LvYegor/diploma-bsuir/doc/img/pcb_elegance2.png

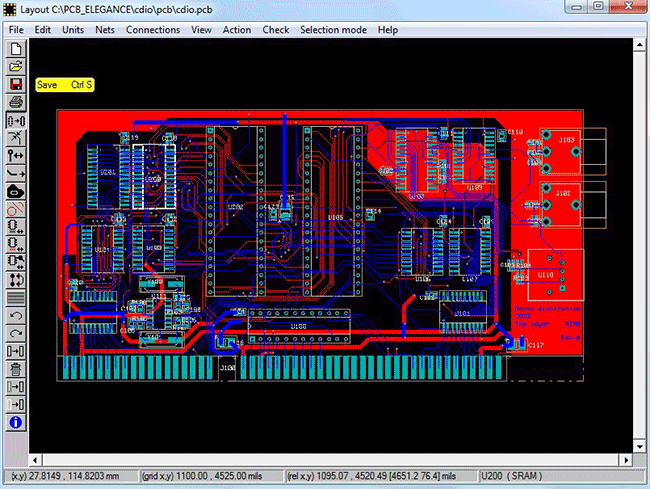
doc/img/pcb_elegance2.png
