LvYegor/diploma-bsuir/doc/img/autoCAD_electrical2.jpg

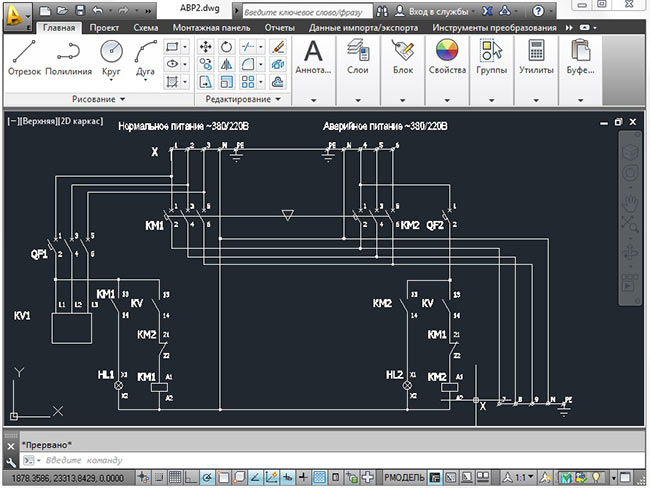
doc/img/autoCAD_electrical2.jpg
