LvYegor/diploma-bsuir/Конференция/Презентация.pdf

## ПРОГРАММНО-АППАРАТНЫЙ КОМПЛЕКС ДЛЯ УПРАВЛЕНИЯ ТЕПЛИЦЕЙ НА ОСНОВЕ БЕСПРОВОДНОЙ ТЕХНОЛОГИИ

Андриевский Егор Сергеевич | Куприянова Диана Вячеславовна

26/04/2024

ДОКЛАДЧИК | РУКОВОДИТЕЛЬ

ДАТА

студент группы 050501 | старший преподаватель кафедры ЭВМ

# ЦЕЛЬ И ЗАДАЧИ

Разработать программно-аппаратный комплекс для управления теплицей на основе беспроводной технологии

## Цель

проектирование контроллера теплицы, представленного в виде платы микроконтроллера и набора датчиков для сбора данных

разработка программного обеспечения для обработки информации и обеспечения взаимодействия между компонентами

реализация удаленного мониторинга и управления теплицей через API

тестирование функционала беспроводного управления и совместимости с подключенными устройствами

## Задачи

# ИСПОЛЬЗУЕМЫЕ ТЕХНОЛОГИИ

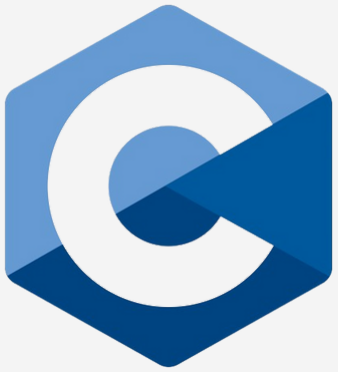
[picture p3: figure]
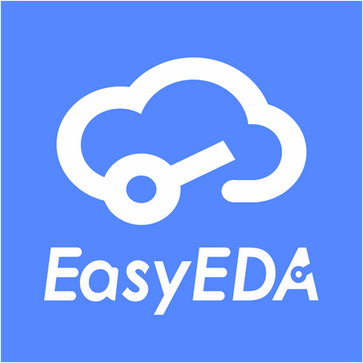
[picture p4: figure]
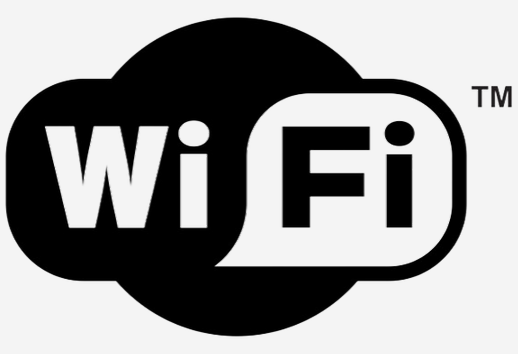
[picture p5: figure]
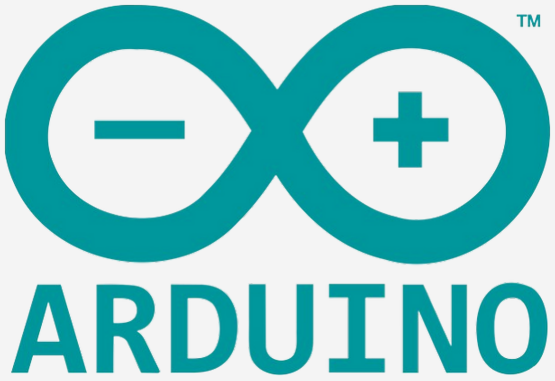
[picture p6: figure]
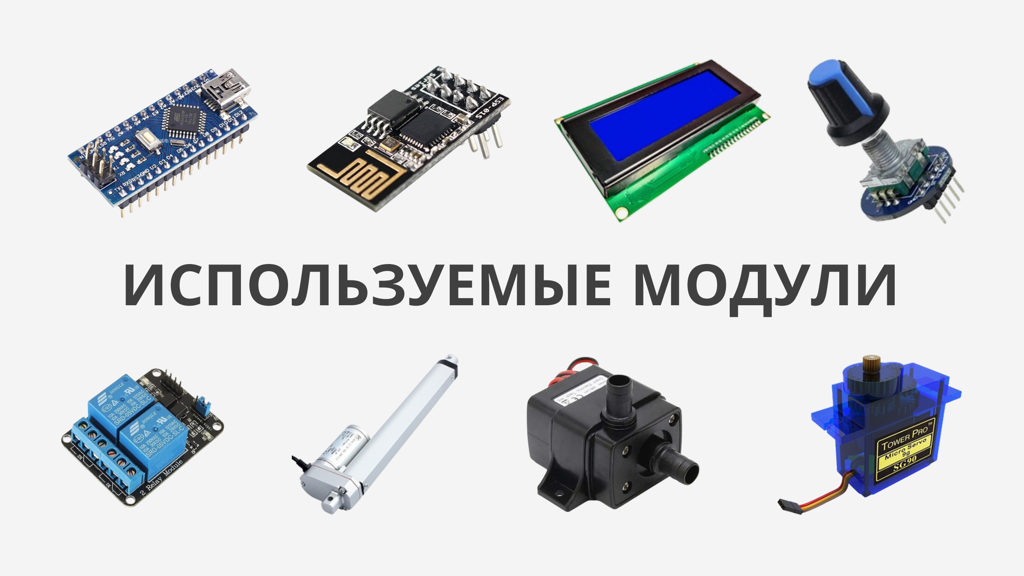
[picture p7: page 4]

# ИСПОЛЬЗУЕМЫЕ МОДУЛИ

# API

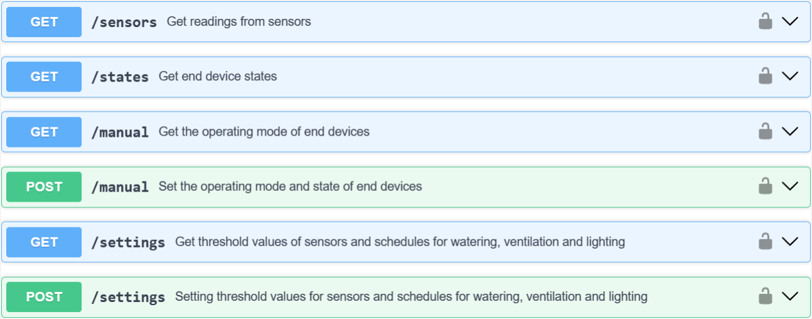
[picture p8: figure]

# ПЕЧАТНАЯ ПЛАТА

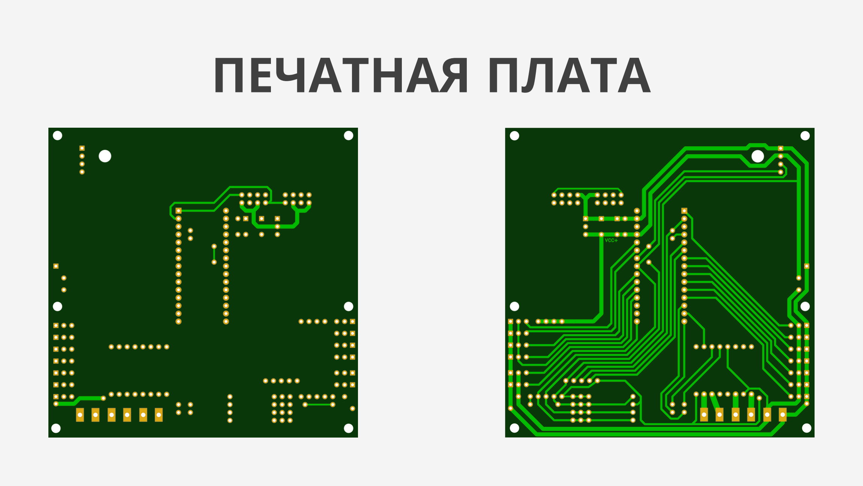
[picture p9: page 6]

# КОРПУС УСТРОЙСТВА

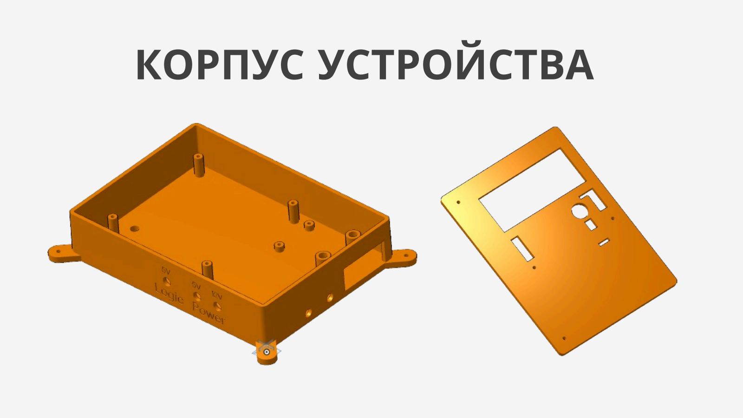
[picture p10: page 7]

# ИСПОЛЬЗУЕМЫЕ ИСТОЧНИКИ

[1]Документация Arduino Nano [Электронный ресурс]. – Электронные данные. – Режим доступа: https://store.arduino.cc/products/arduino-nano – Дата доступа: 03.04.2024

[2]EasyEDA | [Электронный | ресурс]. | – | Электронные | данные. | – | Режим | доступа:
https://easyeda.com/ru – Дата доступа: 03.04.2024

[3]UART – Последовательный интерфейс передачи данных [Электронный ресурс]. – Электронные данные. – Режим доступа: https://voltiq.ru/wiki/uart-interface/ – Дата доступа: 17.04.2024

[4]Интерфейс I2C: принципы функционирования [Электронный ресурс]. – Электронные данные. – Режим доступа: https://dzen.ru/a/Y8-Xp4mc1StLbKbz – Дата доступа: 17.04.2024

[5]ESP-01 WiFi Module [Электронный ресурс]. – Электронные данные. – Режим доступа: https://www.microchip.ua/wireless/esp01.pdf – Дата доступа: 17.04.2024
