LvYegor/diploma-bsuir/doc/Титульный_Лист_ДП.docx

Министерство образования Республики Беларусь

Учреждение образования

БЕЛОРУССКИЙ ГОСУДАРСТВЕННЫЙ УНИВЕРСИТЕТ

ИНФОРМАТИКИ И РАДИОЭЛЕКТРОНИКИ

Факультет компьютерных систем и сетей

Кафедра электронных вычислительных машин

К ЗАЩИТЕ ДОПУСТИТЬ

Зав. каф. ЭВМ

___________ Б.В. Никульшин

ПОЯСНИТЕЛЬНАЯ ЗАПИСКА

к дипломному проекту

на тему

ПРОГРАММНО-АППАРАТНЫЙ КОМПЛЕКС ДЛЯ УПРАВЛЕНИЯ ТЕПЛИЦЕЙ НА ОСНОВЕ БЕСПРОВОДНОЙ ТЕХНОЛОГИИ

БГУИР ДП 1–40 02 01 01 005 ПЗ

Студент Е.С. Андриевский

Руководитель Д.В. Куприянова

Консультанты:

от кафедры ЭВМ Д.В. Куприянова

по экономической части В.Г. Горовой

Нормоконтролер А.И. Стракович

Рецензент

МИНСК 2024
