LvYegor/diploma-bsuir/ПДП/Титульный_Лист_ПДП.docx

Министерство образования Республики Беларусь

Учреждение образования

БЕЛОРУССКИЙ ГОСУДАРСТВЕННЫЙ УНИВЕРСИТЕТ

ИНФОРМАТИКИ И РАДИОЭЛЕКТРОНИКИ

Факультет компьютерных систем и сетей

Кафедра электронных вычислительных машин

Отчет по преддипломной практике

Студент Е.С. Андриевский

Руководитель Д.В. Куприянова

Консультант от кафедры ЭВМ Д.В. Куприянова

Нормоконтролер А.И. Стракович

МИНСК 2024
