LvYegor/diploma-bsuir/doc/pdf/Ведомость_А4.pdf

Изм. Лист | | № докум. | Подп. | Дата
Разраб. | Андриевский | | | Программно-аппаратный комплекс для управления теплицей. Ведомость документов | Лит. | Лист | Листов
Пров. | Куприянова | | | | | У | | 1 | 2
Т. контр. | Куприянова | | | | ЭВМ, гр. 050501
Н. контр. | Стракович
Утв. | Никульшин

## БГУИР ДП 1–400201 01 005 Д1

Обозначение | Наименование | Примечание
| Графические документы
ГУИР.400201.005 ПД.1 ГУИР.400201.005 ПД.1 | Программное обеспечение Программное обеспечение
| контроллера теплицы для Arduino. контроллера теплицы для Arduino.
| Схема программы Схема программы | А2 А2
ГУИР.400201.005 ПД.2 ГУИР.400201.005 ПД.2 | Программное обеспечение Программное обеспечение
| контроллера теплицы для ESP-01. контроллера теплицы для ESP-01.
| Схема программы Схема программы | А2 А2
ГУИР.400201.005 ПЛ.1 | Вводный плакат. Плакат | А1
ГУИР.400201.005 ПЛ.2 | Заключительный плакат. Плакат | А1
ГУИР.400201.005 Э1 ГУИР.400201.005 Э1 | Программно-аппаратный комплекс для Программно-аппаратный комплекс для
| управления теплицей. управления теплицей.
| Схема электрическая структурная Схема электрическая структурная | А1 А1
ГУИР.400201.005 С1 ГУИР.400201.005 С1 | Программно-аппаратный комплекс для Программно-аппаратный комплекс для
| управления теплицей. управления теплицей.
| Схема структурная Схема структурная | А1 А1
ГУИР.400201.005 Э3 ГУИР.400201.005 Э3 | Программно-аппаратный комплекс для Программно-аппаратный комплекс для
| управления теплицей. управления теплицей.
| Схема электрическая принципиальная Схема электрическая принципиальная | А1 А1
ГУИР.400201.005 МЭ ГУИР.400201.005 МЭ | Программно-аппаратный комплекс для Программно-аппаратный комплекс для
| управления теплицей. управления теплицей.
| Чертеж электромонтажный Чертеж электромонтажный | А4 А4
| Текстовые документы
БГУИР ДП БГУИР ДП 1–400201 01 005 400201 01 005 ПЗ | Пояснительная записка Пояснительная записка | 157 с.
ГУИР.400201.005 Д2 ГУИР.400201.005 Д2 | Программно-аппаратный комплекс для Программно-аппаратный комплекс для
| управления теплицей. управления теплицей.
| Спецификация Спецификация | 1 л., в ПЗ

Изм. Лист | № докум. | Подп. | Дата

## БГУИР ДП 1–400201 01 005 Д1

Лист
2
Обозначение | Наименование | Примечание
ГУИР.400201.005 ПЭ3 | Программно-аппаратный комплекс для
| управления теплицей.
| Перечень элементов | 2 л., в ПЗ
| Отзыв руководителя
| Отчет проверки на заимствования | 2 л.
| Рецензия
