LvYegor/diploma-bsuir/doc/pdf/Перечень_элементов_А4.pdf

Изм. Лист | | № докум. | Подп. | Дата
Разраб. | Андриевский | | | Программно-аппаратный комплекс для управления теплицей. Перечень элементов | Лит. | Лист | Листов
Пров. | Куприянова | | | | | У | | 1 | 2
Т. контр. | Куприянова | | | | ЭВМ, гр. 050501
Н. контр. | Стракович
Утв. | Никульшин

## ГУИР.400201.005 ПЭ3

Поз. обозна-чение | Наименование | | Примечание
| Микросхемы
B1 B1 | GY-30 (BH1750FVI), датчик интенсивности GY-30 (BH1750FVI), датчик интенсивности
| освещенности освещенности | 1 1
B2 B2 | DHT22, модуль датчика температуры и DHT22, модуль датчика температуры и
| влажности влажности | 1 1
B3 | Water Sensor, датчик уровня воды | 1
B4 B4 | BME280, датчик атмосферного давления, BME280, датчик атмосферного давления,
| влажности и температуры влажности и температуры | 1 1
B5, B6 | YL-38, датчик влажности почвы | 2
B7 | YL-69, щуп датчика влажности почвы | 1
B8 | MH-RD, щуп датчика дождя | 1
DA1 DA1 | AMS1117 mini 3,3В, модуль стабилизатора AMS1117 mini 3,3В, модуль стабилизатора
| напряжения напряжения | 1 1
DD1 | ESP-01 (ESP8266), модуль WiFi | 1
DD2 | TB6612FNG Ultra L298N, драйвер моторов
| двухканальный | 1
DD3 DD3 | Nano V3.0 ATmega328P CH340G 16 МГц, Nano V3.0 ATmega328P CH340G 16 МГц,
| плата микроконтроллера плата микроконтроллера | 1 1
DD4 DD4 | DS3231 (AT24C32), 3,3В / 5В, модуль RTC DS3231 (AT24C32), 3,3В / 5В, модуль RTC
| часов реального времени часов реального времени | 1 1
DD5 DD5 | HW-061, модуль последовательного HW-061, модуль последовательного
| интерфейса I2C для дисплея LCD2004 интерфейса I2C для дисплея LCD2004 | 1 1
DD6 DD6 | EC11, модуль энкодера с кнопкой и ручкой EC11, модуль энкодера с кнопкой и ручкой
| 360°, 20 импульсов за цикл 360°, 20 импульсов за цикл | 1 1
EL1 | SMD2835, светодиодная лента, 12В, 9,6Вт | 1
HG1 | LCD2004 IIC/I2C, ЖК-дисплей 20х4 символов | 1
M1 M1 | DC30E, насос центробежный погружной с DC30E, насос центробежный погружной с
| мокрым ротором, 240 л/ч, 12В, 4,2Вт мокрым ротором, 240 л/ч, 12В, 4,2Вт | 1 1

Зона
Кол.

Изм. Лист | № докум. | Подп. | Дата

## ГУИР.400201.005 ПЭ3

Поз. обозна-чение | Наименование | | Примечание
M2 M2 | 750N, линейный привод (актуатор), 12 В, 750N, линейный привод (актуатор), 12 В,
| длина хода 350 мм., 10 мм/с, до 75 кг длина хода 350 мм., 10 мм/с, до 75 кг | 1 1
M3, M4 | SG90, cервопривод, 1,8 кг.см, 180° | 2

Зона
Кол.

Лист
2
| Устройства коммутации
KM1 | Модуль реле, 2 канала, 5В | 1
SW1 SW1 | PBS-10B-2, кнопка без фиксации OFF-(ON), 1А, PBS-10B-2, кнопка без фиксации OFF-(ON), 1А,
| 250В 250В | 1 1
| Блоки питания
XP1 | Блок питания, 12В, 5А | 1
XP2, XP3 Блок питания, Блок питания, 5В, 2А | | 2
