LvYegor/diploma-bsuir/doc/pdf/Презентация.pdf

# Программно-аппаратный комплекс для управления теплицей на основе беспроводной технологии

Автор:
Андриевский Егор Сергеевич

Руководитель:
Куприянова Диана Вячеславовна

# Цель и задачи

Цель:
Разработать программно-аппаратный комплекс для управления теплицей на основе беспроводной технологии Wi-Fi.
Задачи:
– проектирование контроллера теплицы, представленного в виде платы микроконтроллера и набора датчиков для сбора данных;
– разработка программного обеспечения для обработки информации и обеспечения взаимодействия между компонентами;
– реализация удаленного мониторинга и управления теплицей через API;
– тестирование функционала беспроводного управления и совместимости с подключенными устройствами.

# Аналоги

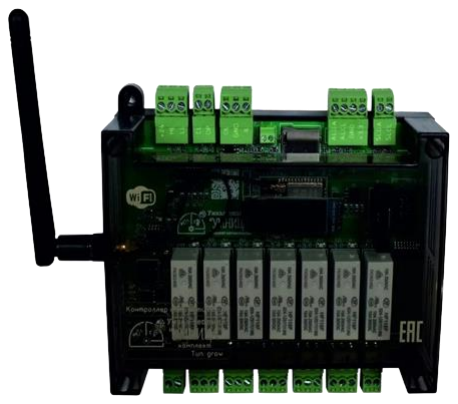
[picture p70: figure]
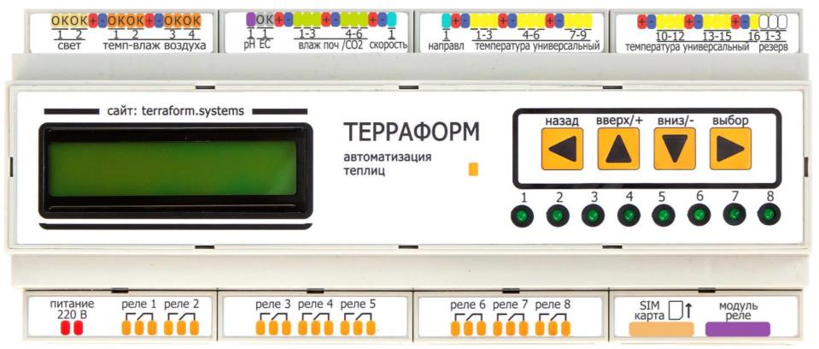
[picture p71: figure]

TECH-UC1002 | УМНИЦА GROW | ТЕРРАФОРМ

# Используемые технологии

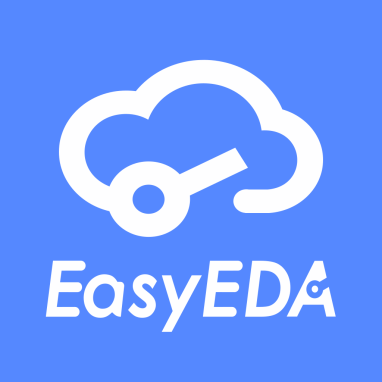
[picture p72: figure]
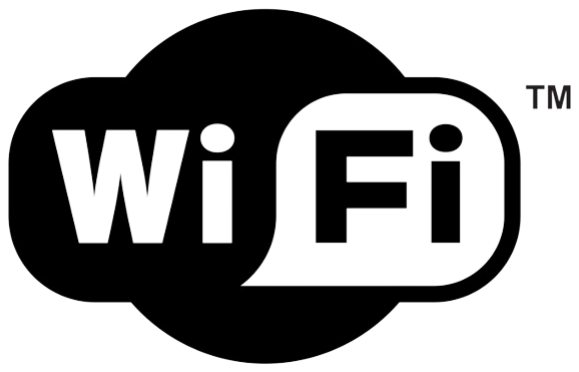
[picture p73: figure]
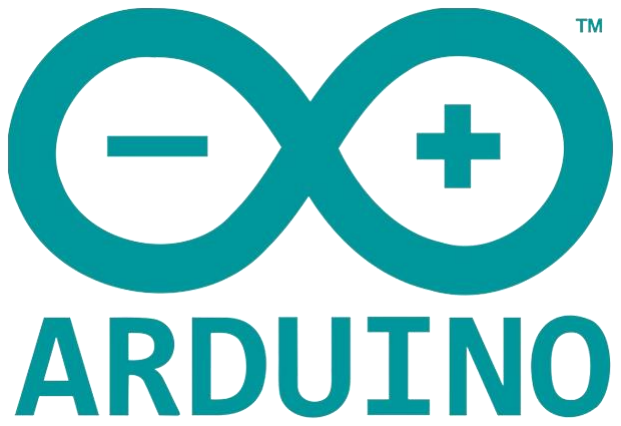
[picture p74: figure]
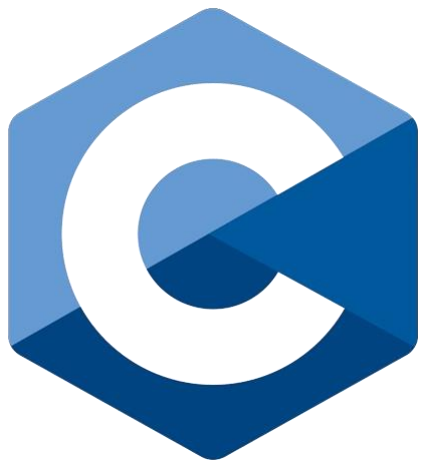
[picture p75: figure]

# Используемые модули

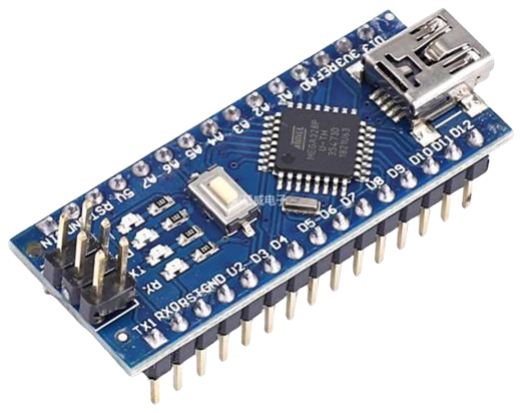
[picture p76: figure]
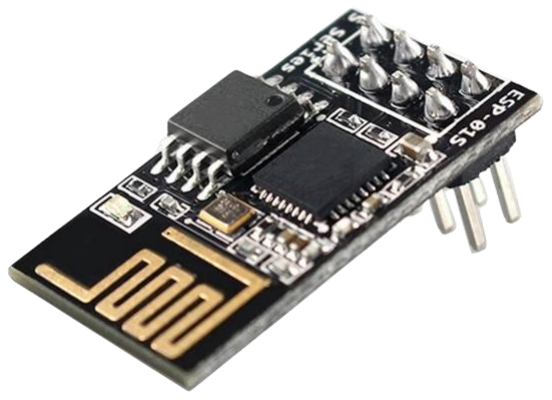
[picture p77: figure]
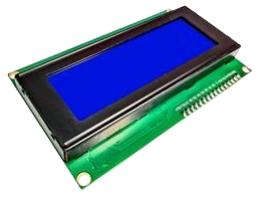
[picture p78: figure]
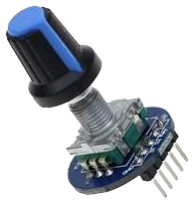
[picture p79: figure]
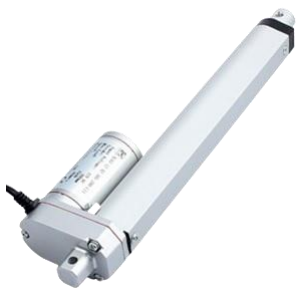
[picture p80: figure]
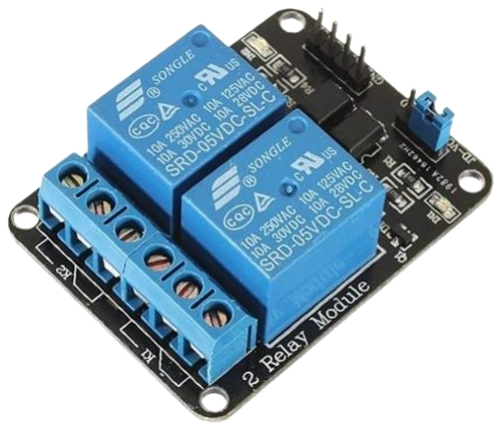
[picture p81: figure]
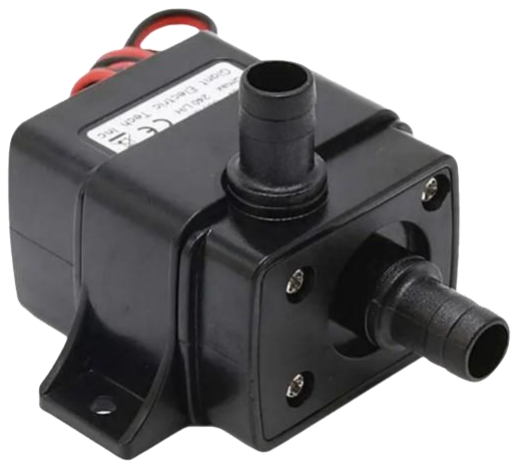
[picture p82: figure]
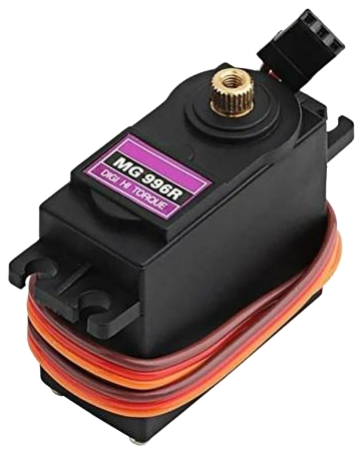
[picture p83: figure]

# Печатная плата

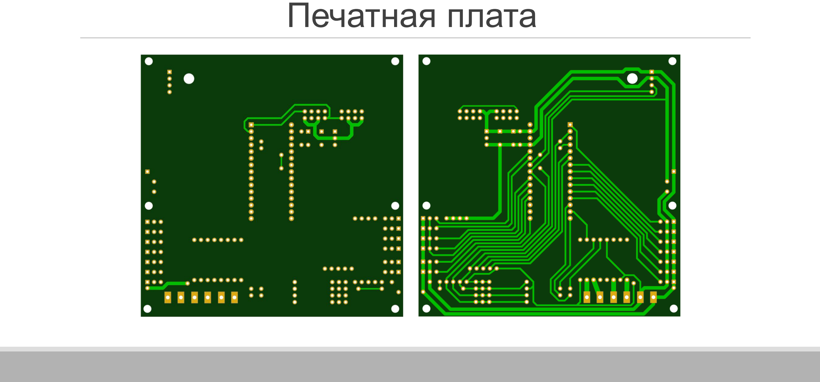
[picture p84: page 6]

# Разработанный контроллер теплицы

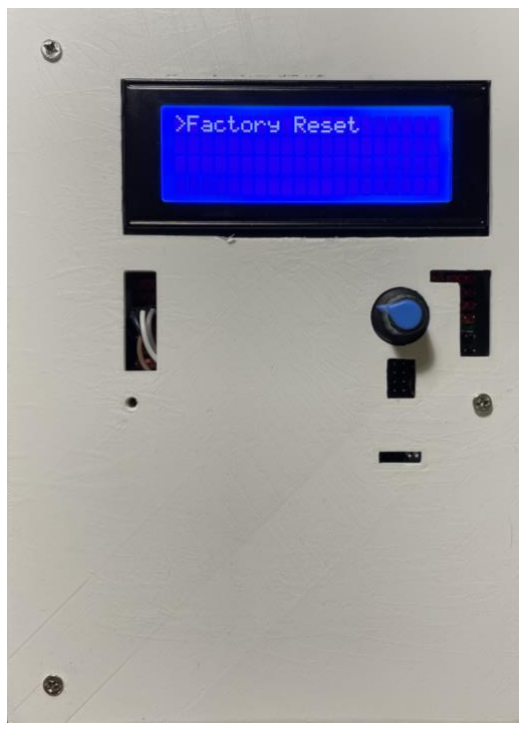
[picture p85: figure]
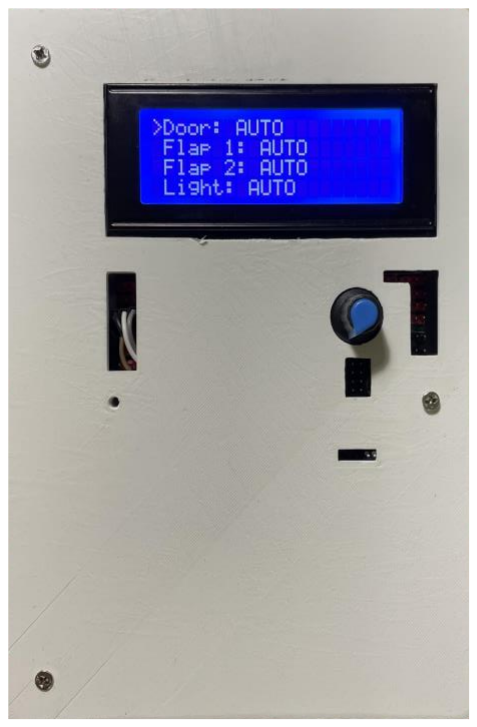
[picture p86: figure]
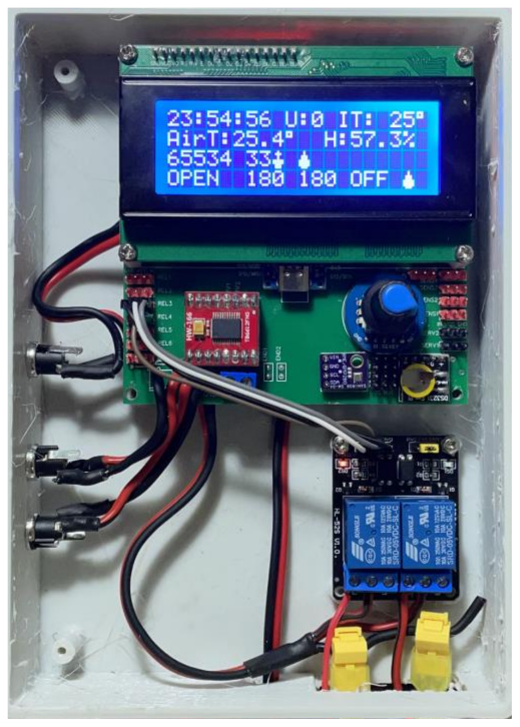
[picture p87: figure]

# API

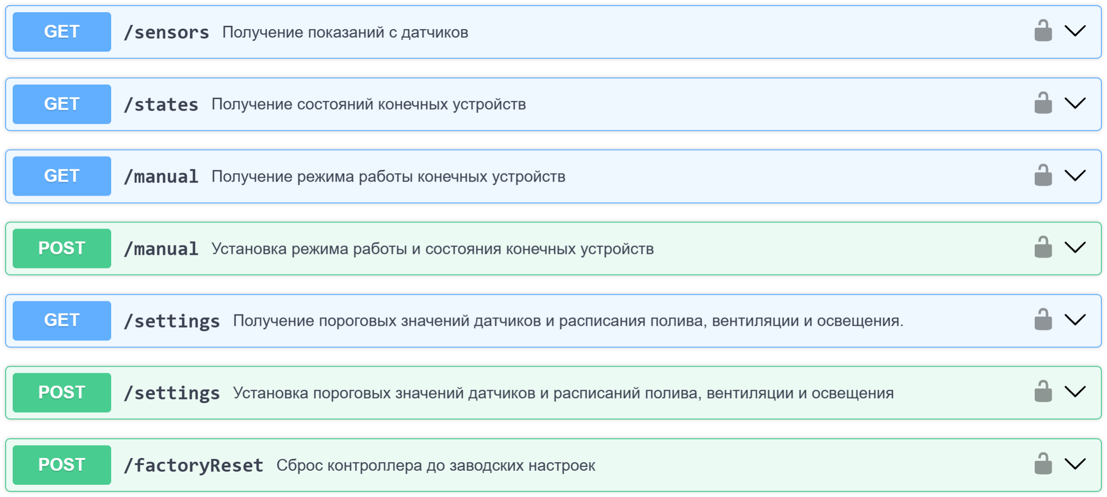
[picture p88: figure]

# API

{
"airT": 25.3,
"airH": 60,
"insideT": 24.8,
"lightLevel": 75,
"soilMoisture": 40,
"enoughWater": true,
"raining": false
}

# API

{
"flap1": 0,
"flap2": 1,
"door": true,
"light": false,
"pump": false
}

# API

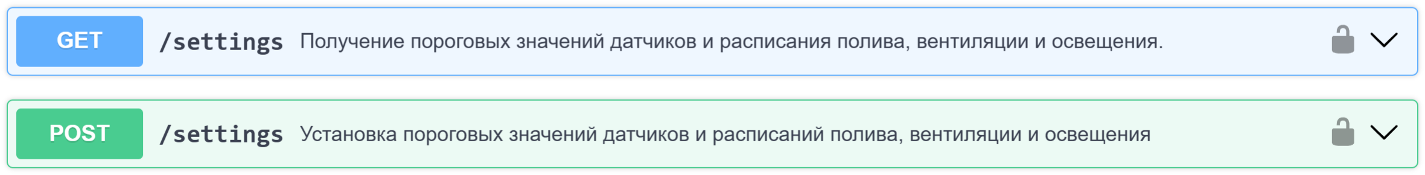
[picture p89: figure]

{
"driveSpeed": 255,
"sensorPeriod": 1,
"flapsTemperatureThreshold": 22.5, "doorTemperatureThreshold": 15.0, "ventelationPeriod": 600,
"ventelationTime": 60,
"closeIfRain": true,
"wateringMoistureThreshold": 30, "wateringTime": 120,
"wateringTimeout": 600,
"wateringPeriod": 3600,
"lightLevelThreshold": 70
}

# Публикации

Андриевский, Е. С. Программно-аппаратный комплекс для управления теплицей на основе беспроводной технологии / Андриевский Е. С. // Компьютерные системы и сети : сборник материалов 60-й научной конференции аспирантов, магистрантов и студентов, Минск, 18– 22 апреля 2024 г. / Белорусский государственный университет информатики и радиоэлектроники. – Минск, 2024 (в печати)

# СПАСИБО ЗА ВНИМАНИЕ
