LvYegor/diploma-bsuir/doc/pdf/Спецификация_А4.pdf

Изм. Лист | | № докум. | Подп. | Дата
Разраб. | Андриевский | | | Программно-аппаратный комплекс для управления теплицей. Спецификация | Лит. | Лист | Листов
Пров. | Куприянова | | | | | У | | 1
Т. контр. | Куприянова | | | | ЭВМ, гр. 050501
Н. контр. | Стракович
Утв. | Никульшин

## ГУИР.400201.005 Д2

Обозначение | Наименование | Примечание
| Документация
12-01 | Текст программы | В составе пояснительной записки
51-01 | Программа и методика
| испытаний | В составе пояснительной записки
81-01 | Пояснительная записка
90-01 | Руководство пользователя | В составе пояснительной записки

Компоненты
GreenHouse.zip. | На DVD-R диске «GreenHouse»

Архивный файл
presentation.pptx. | На DVD-R диске «GreenHouse»
Мультимедийный файл
readme.txt. | На DVD-R диске «GreenHouse»

Текстовый файл
