LvYegor/diploma-bsuir/doc/img/123456789.png

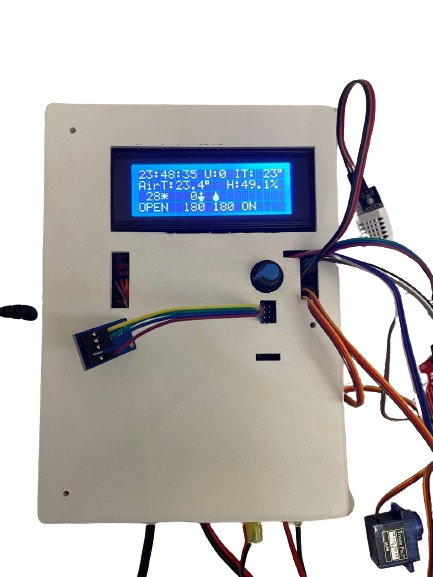
doc/img/123456789.png
