LvYegor/diploma-bsuir/doc/img/6536432983 (1).webp

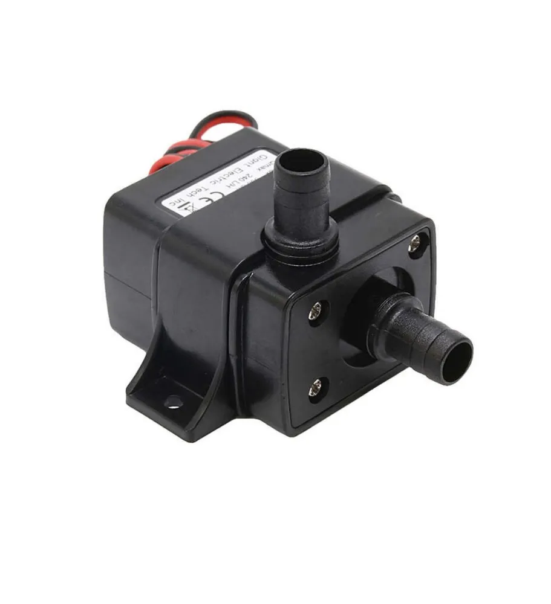
doc/img/6536432983 (1).webp
