LvYegor/diploma-bsuir/doc/img/5215400687571058674.jpeg

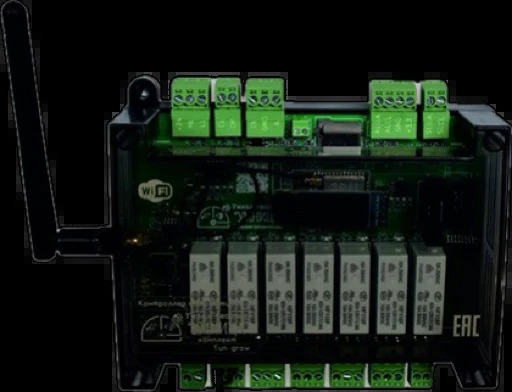
doc/img/5215400687571058674.jpeg
