LvYegor/diploma-bsuir/doc/img/5215400687571058674.webp

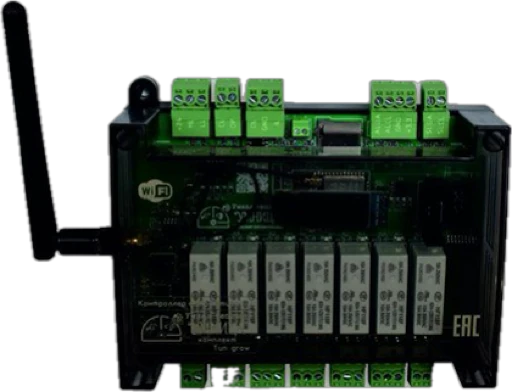
doc/img/5215400687571058674.webp
