LvYegor/diploma-bsuir/doc/img/5217652487384745214.webp

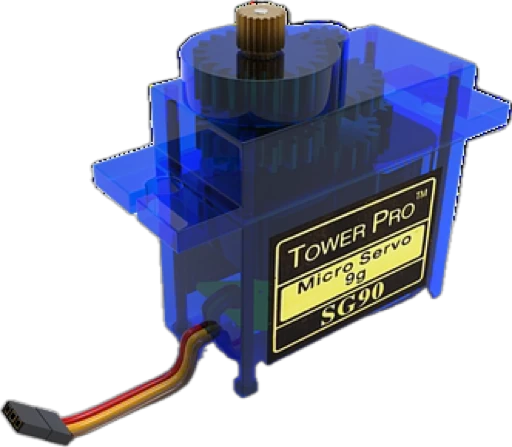
doc/img/5217652487384745214.webp
