LvYegor/diploma-bsuir/doc/img/5353045486396891055_121.jpg

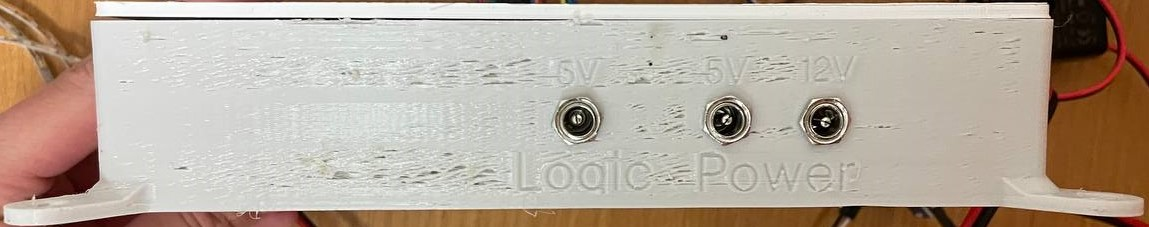
doc/img/5353045486396891055_121.jpg
