LvYegor/diploma-bsuir/doc/img/A000066-pinout.png

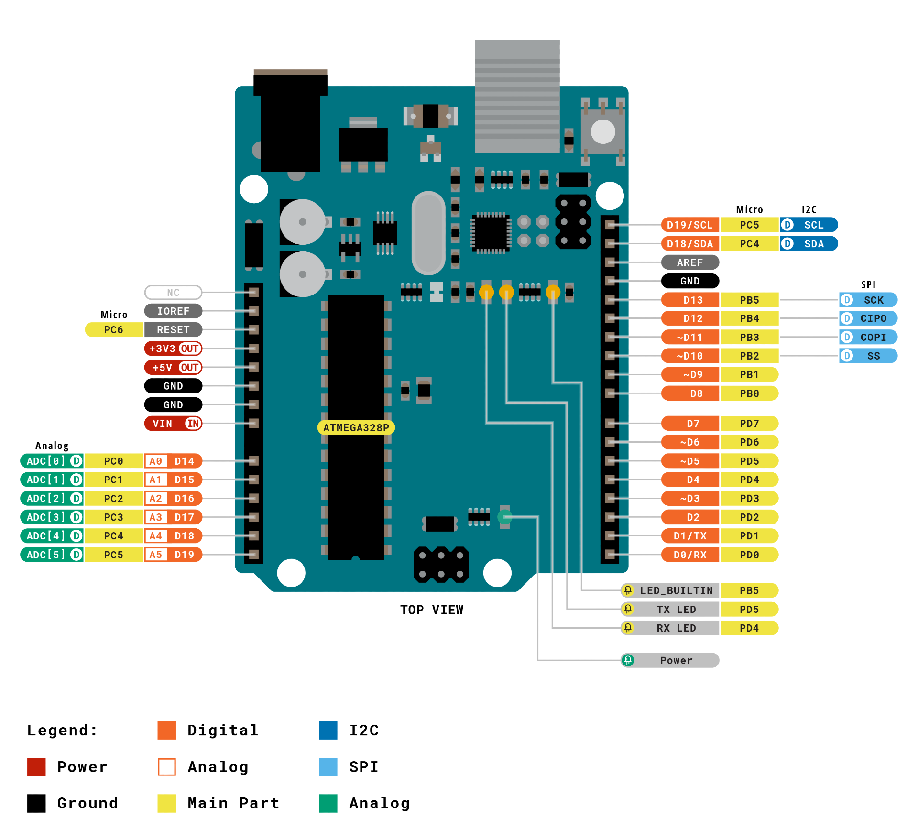
doc/img/A000066-pinout.png
