LvYegor/diploma-bsuir/doc/img/arduino_CONTROLLER_NANO-V3-0_CABLE_5.jpg

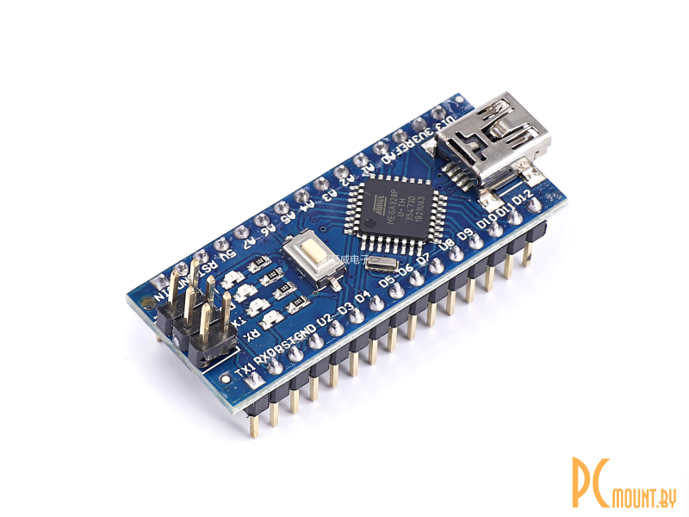
doc/img/arduino_CONTROLLER_NANO-V3-0_CABLE_5.jpg
