LvYegor/diploma-bsuir/doc/img/cometCAD2.png

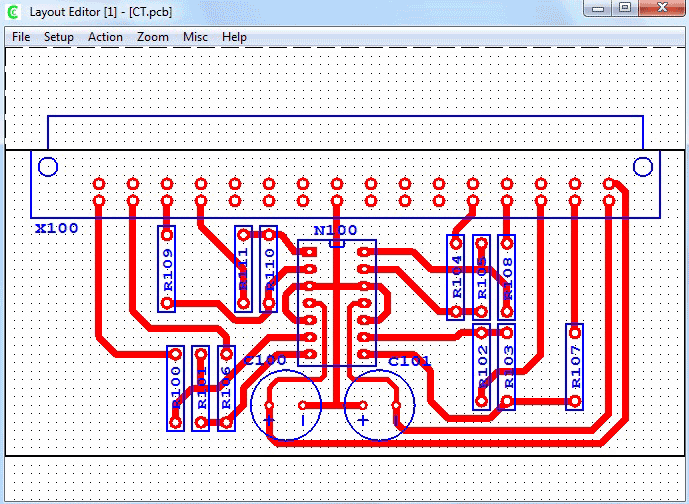
doc/img/cometCAD2.png
