LvYegor/diploma-bsuir/doc/img/esp01plata.png

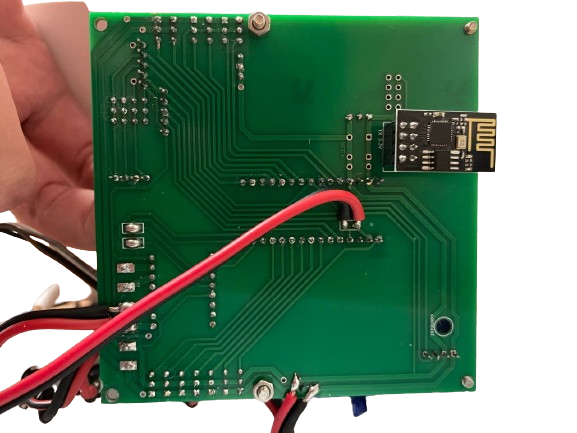
doc/img/esp01plata.png
