LvYegor/diploma-bsuir/doc/img/image-removebg-preview.png

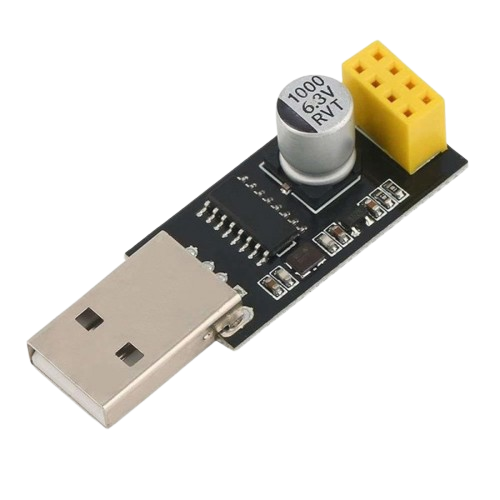
doc/img/image-removebg-preview.png
