LvYegor/diploma-bsuir/doc/img/images.jpg

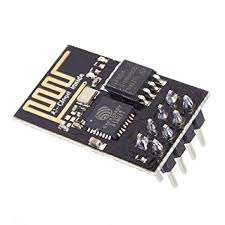
doc/img/images.jpg
