LvYegor/diploma-bsuir/doc/img/mg996r.png

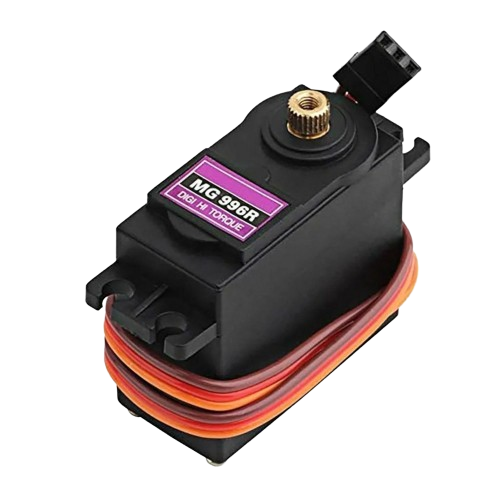
doc/img/mg996r.png
