LvYegor/diploma-bsuir/doc/img/micro-cap1.png

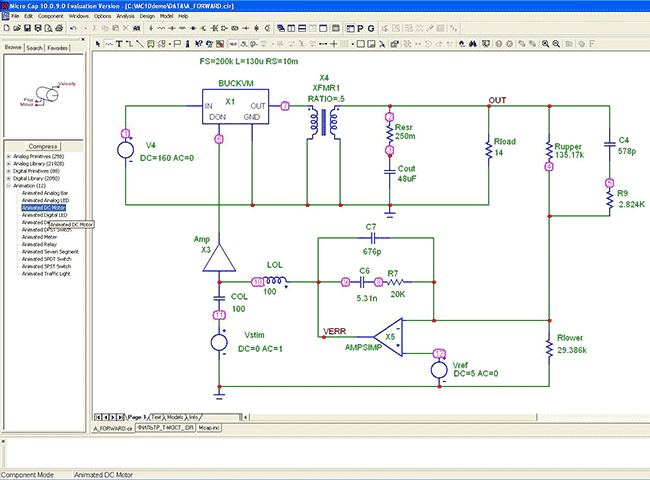
doc/img/micro-cap1.png
