LvYegor/diploma-bsuir/doc/img/optimize.webp

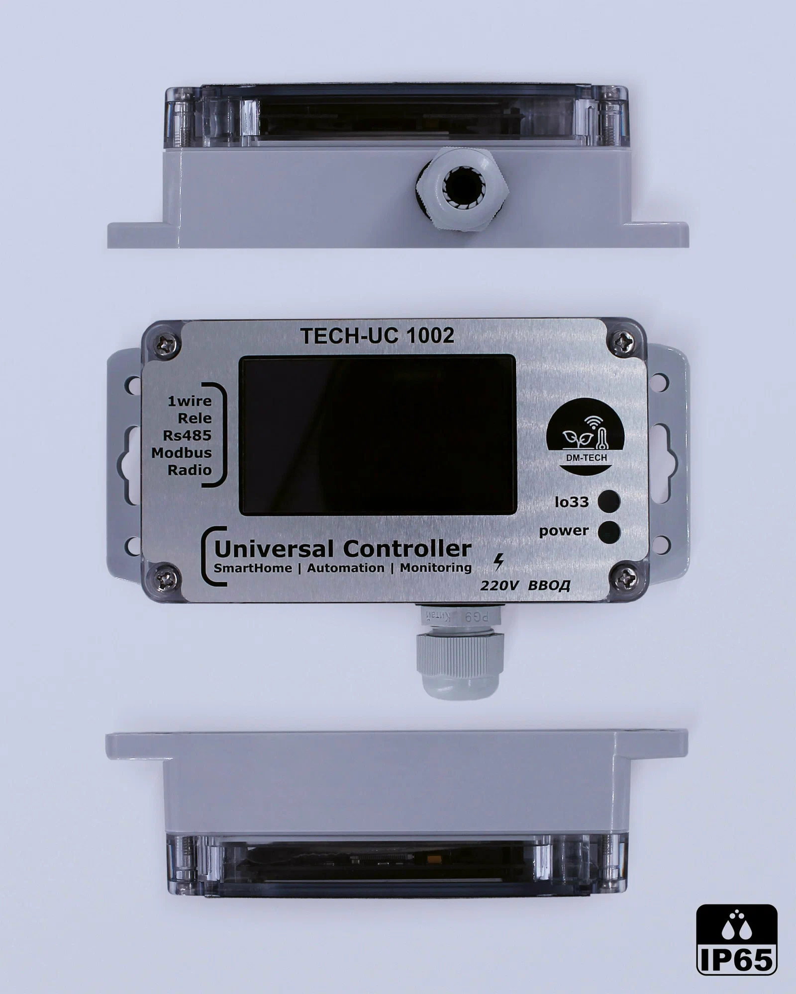
doc/img/optimize.webp
