LvYegor/diploma-bsuir/doc/img/Pinout-NANO_latest.png

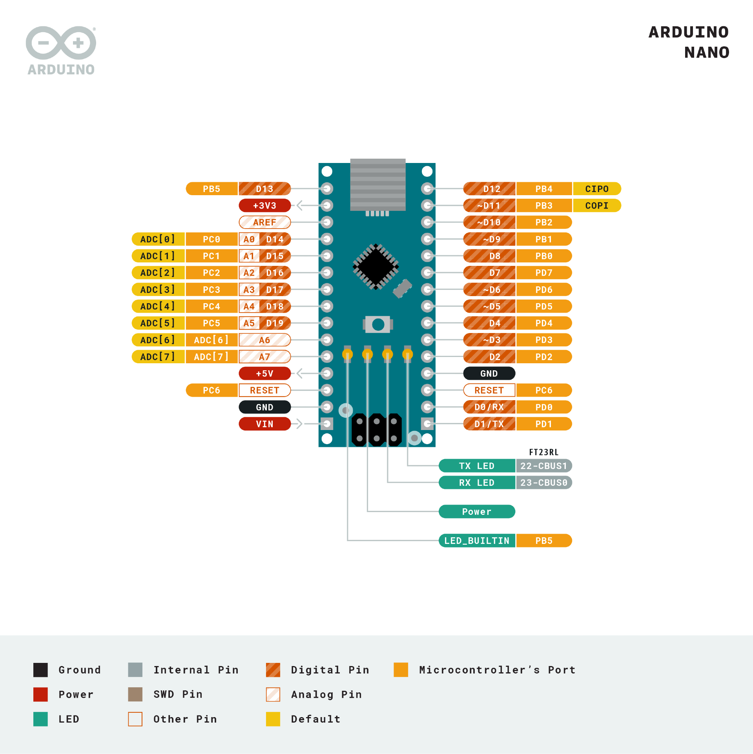
doc/img/Pinout-NANO_latest.png
