LvYegor/diploma-bsuir/doc/img/platf1.png

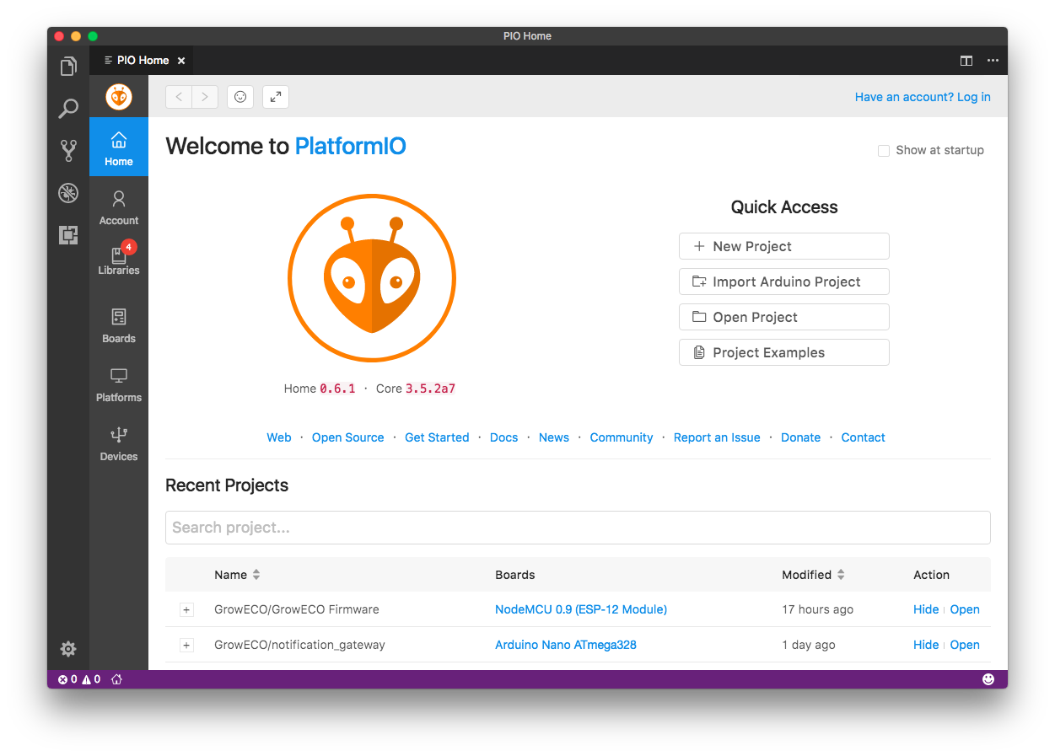
doc/img/platf1.png
