LvYegor/diploma-bsuir/doc/img/power.png

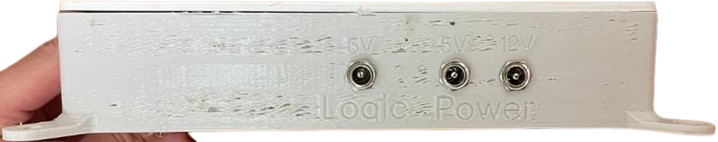
doc/img/power.png
