LvYegor/diploma-bsuir/doc/img/proteus-vsm-software-atmel-avr-microprocessor-descimage.jpg

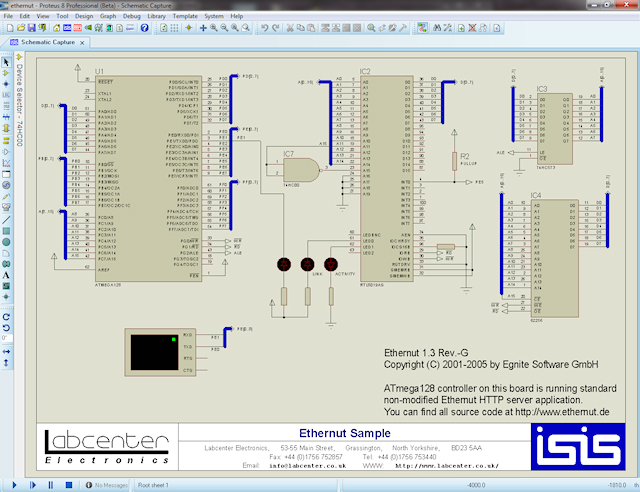
doc/img/proteus-vsm-software-atmel-avr-microprocessor-descimage.jpg
