LvYegor/diploma-bsuir/doc/img/scale_1200.jpg

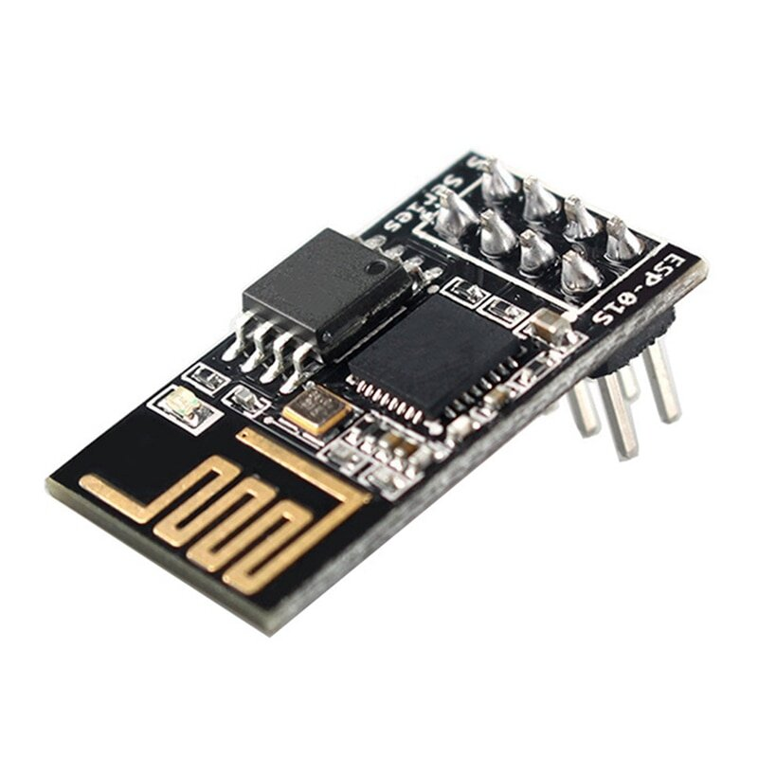
doc/img/scale_1200.jpg
