LvYegor/diploma-bsuir/doc/img/sparkfun-arduino-pro-mini-328-5v-16mhz.png

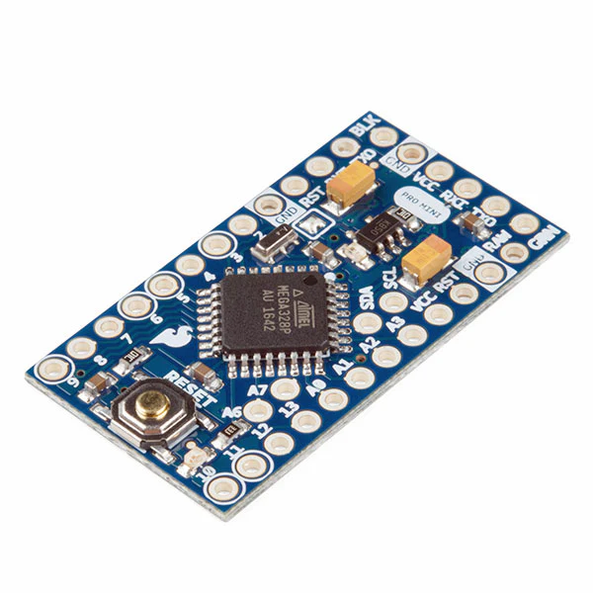
doc/img/sparkfun-arduino-pro-mini-328-5v-16mhz.png
