LvYegor/diploma-bsuir/doc/img/untitled-camera_4.29.png

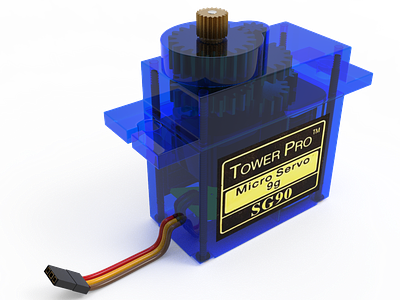
doc/img/untitled-camera_4.29.png
