LvYegor/diploma-bsuir/doc/img_control/final/IMG_0617.jpg

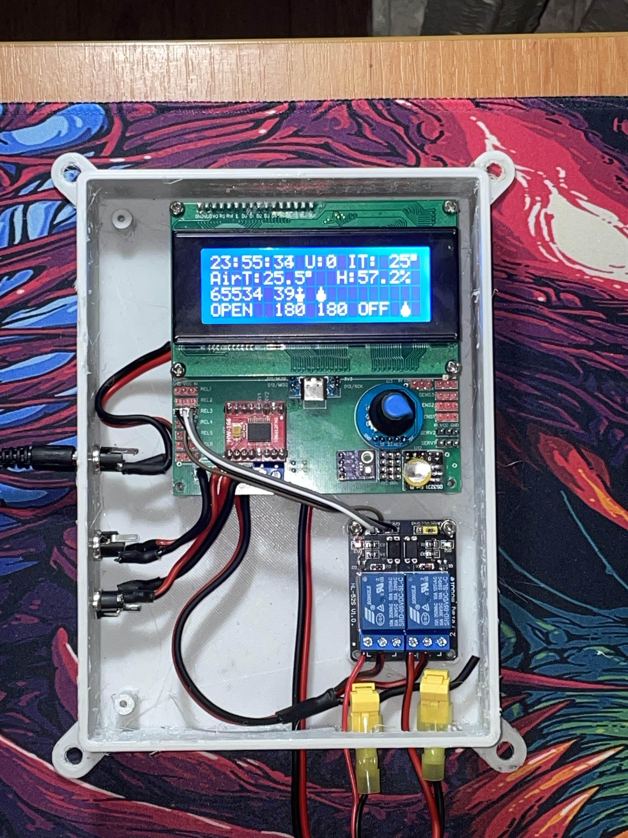
doc/img_control/final/IMG_0617.jpg
