LvYegor/diploma-bsuir/doc/img_control/final/IMG_0620.jpg

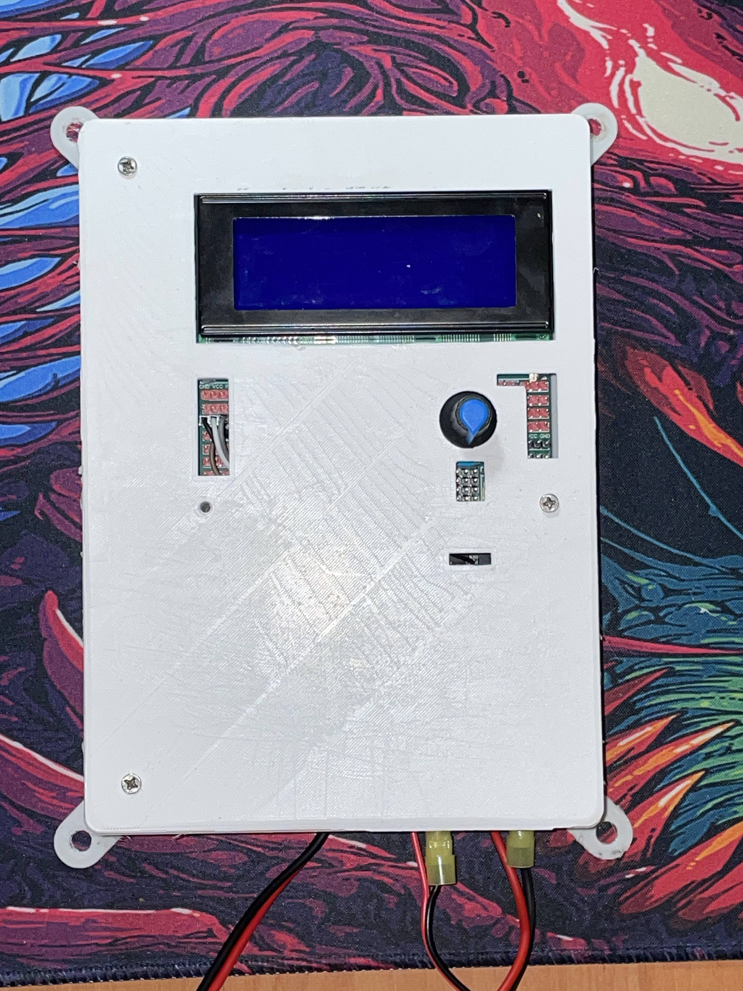
doc/img_control/final/IMG_0620.jpg
