LvYegor/diploma-bsuir/Конференция/img/ams1117.png

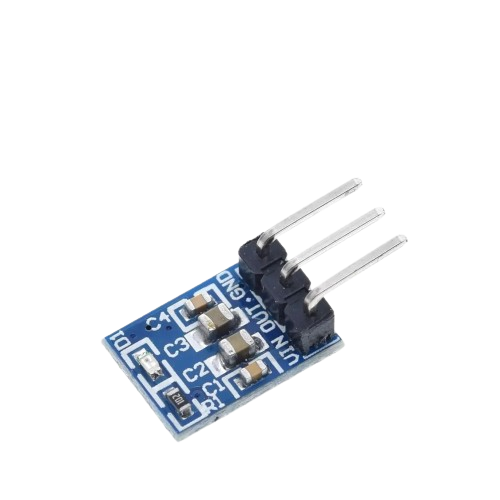
Конференция/img/ams1117.png
