LvYegor/diploma-bsuir/Конференция/img/api.png

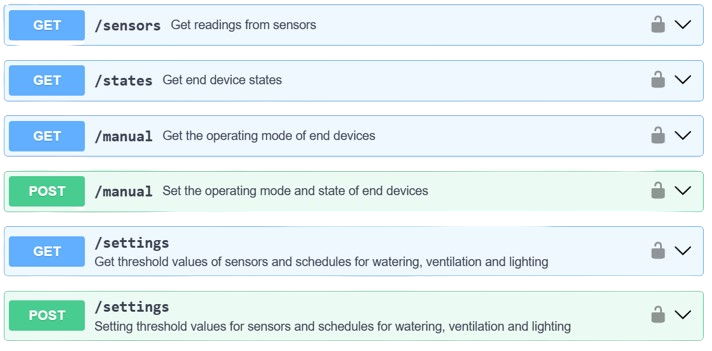
Конференция/img/api.png
