LvYegor/diploma-bsuir/Конференция/img/arduino.png

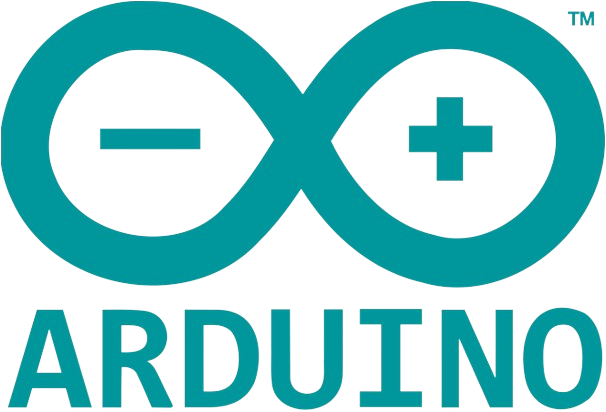
Конференция/img/arduino.png
