LvYegor/diploma-bsuir/Конференция/img/box1.png

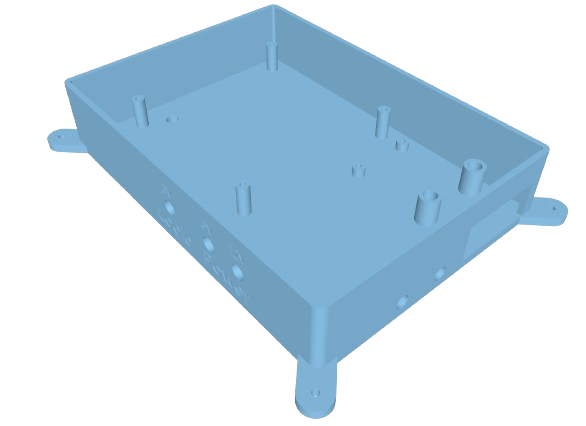
Конференция/img/box1.png
