LvYegor/diploma-bsuir/Конференция/img/esp-01.png

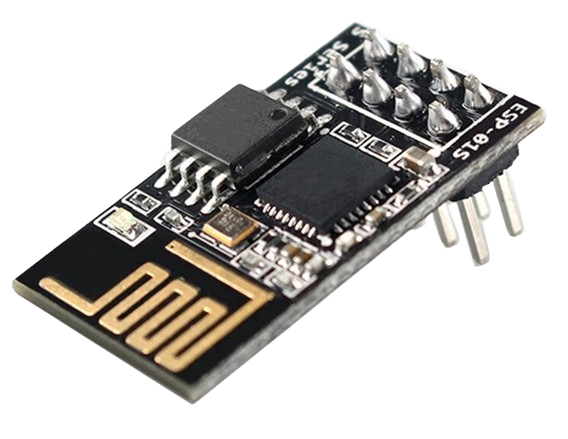
Конференция/img/esp-01.png
