LvYegor/diploma-bsuir/Конференция/img/image-removebg-preview.png

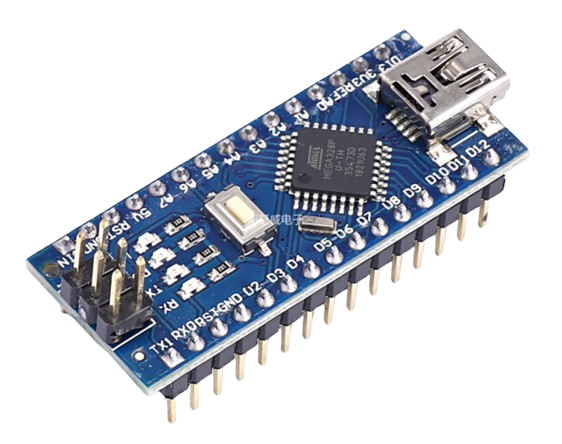
Конференция/img/image-removebg-preview.png
