LvYegor/diploma-bsuir/Конференция/img/IMG_0449.PNG

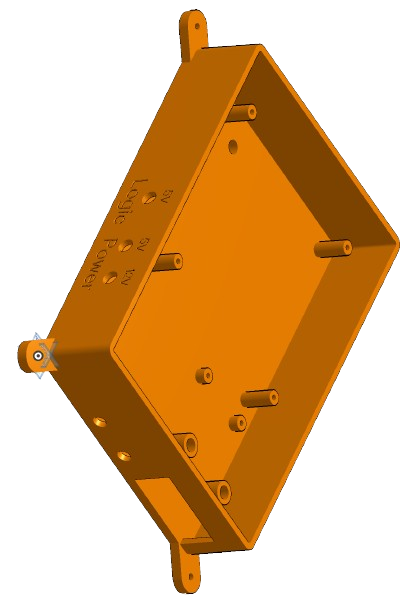
Конференция/img/IMG_0449.PNG
