LvYegor/diploma-bsuir/Конференция/img/IMG_0449123123.png

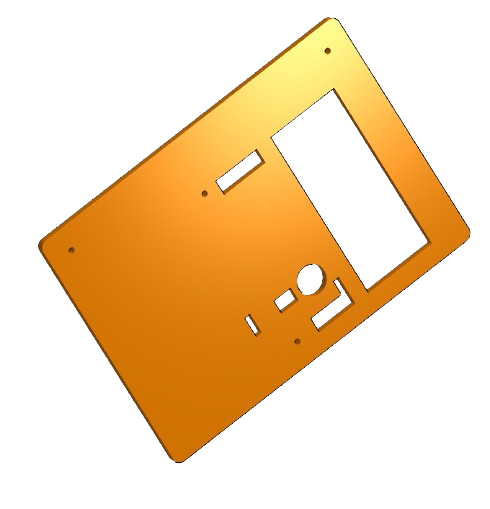
Конференция/img/IMG_0449123123.png
