LvYegor/diploma-bsuir/Конференция/img/rele.png

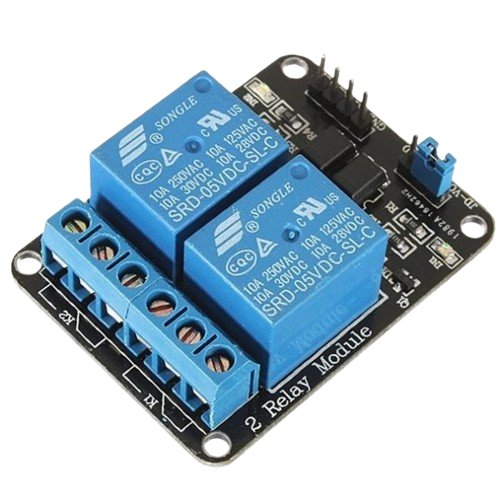
Конференция/img/rele.png
