LvYegor/diploma-bsuir/Конференция/img/servo.png

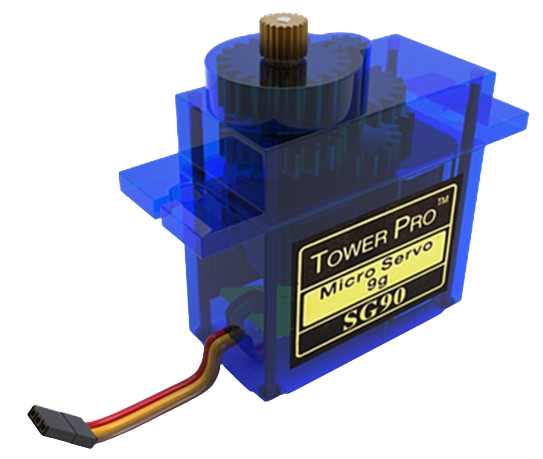
Конференция/img/servo.png
