LvYegor/diploma-bsuir/Конференция/img/wifi.png

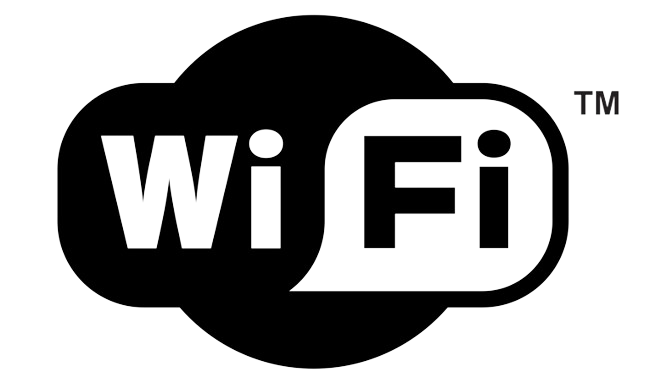
Конференция/img/wifi.png
