LvYegor/diploma-bsuir/Конференция/img/Просмотр-платы_2024-04-25.png

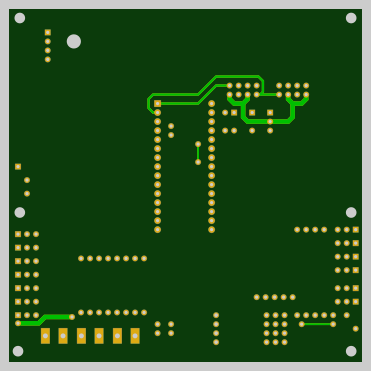
Конференция/img/Просмотр-платы_2024-04-25.png
