LvYegor/diploma-bsuir/case/Case-Lid-new.stl

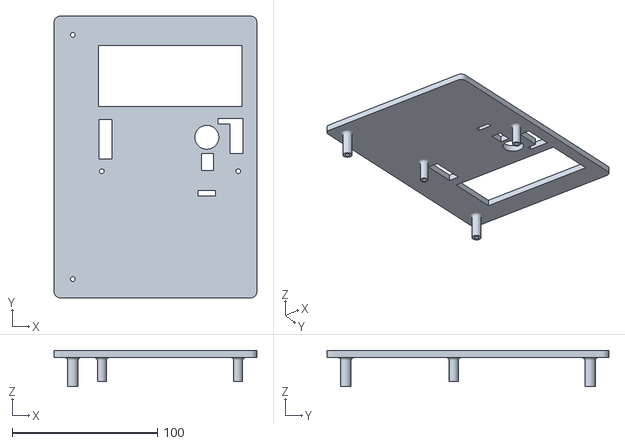
[picture p134: CAD file, 2024-05-24]
case/Case-Lid-new.stl
140.0 x 194.4 x 25.0
