LvYegor/diploma-bsuir/greenhouseControl_ESP01/GyverControl_ESP01/Case.FCStd

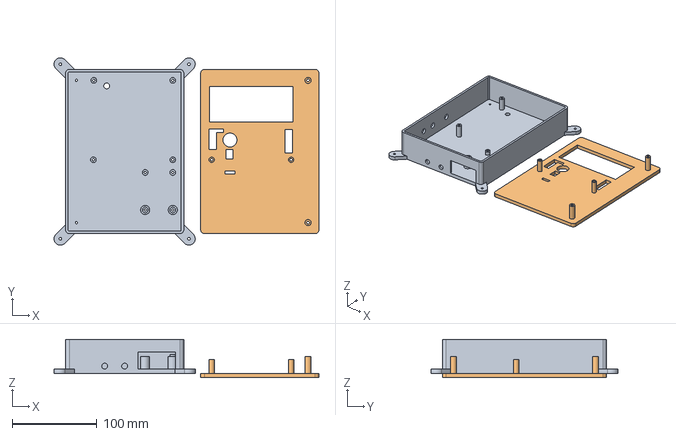
[picture p135: CAD file, 2024-05-24]
greenhouseControl_ESP01/GyverControl_ESP01/Case.FCStd
313.6 x 221.6 x 45.0 mm
Lid
