LvYegor/diploma-bsuir/greenhouseControl_ESP01/GyverControl_ESP01/Case-Body.stl

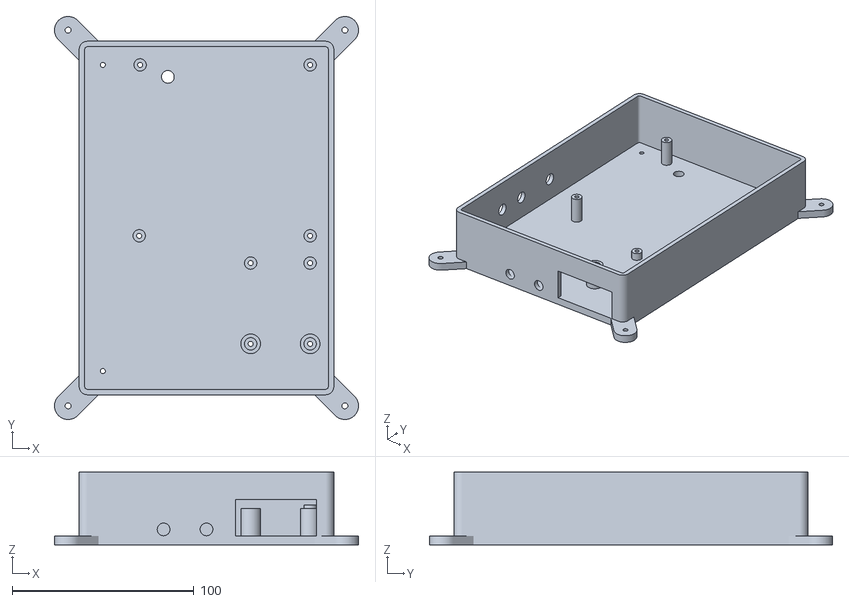
[picture p136: CAD file, 2024-05-24]
greenhouseControl_ESP01/GyverControl_ESP01/Case-Body.stl
167.2 x 221.6 x 40.0
