LvYegor/diploma-bsuir/(list of files, cad)

Other CAD files:
greenhouseControl_ESP01/GyverControl_ESP01/Case-Lid.stl
