LvYegor/diploma-bsuir/doc/pdf/Принципиальная_А1.pdf

# DABCEFGHJKLMNPQRSTUVWXYZ

01 02 03 04 05 06 07 08 09 10 11 12 13 14 15 16 17 18 19 20 21 22 23 24 25 26 27 28 29 30 31 32 33 34 35 36 37 38 39 40 41 42 43 44 45 46

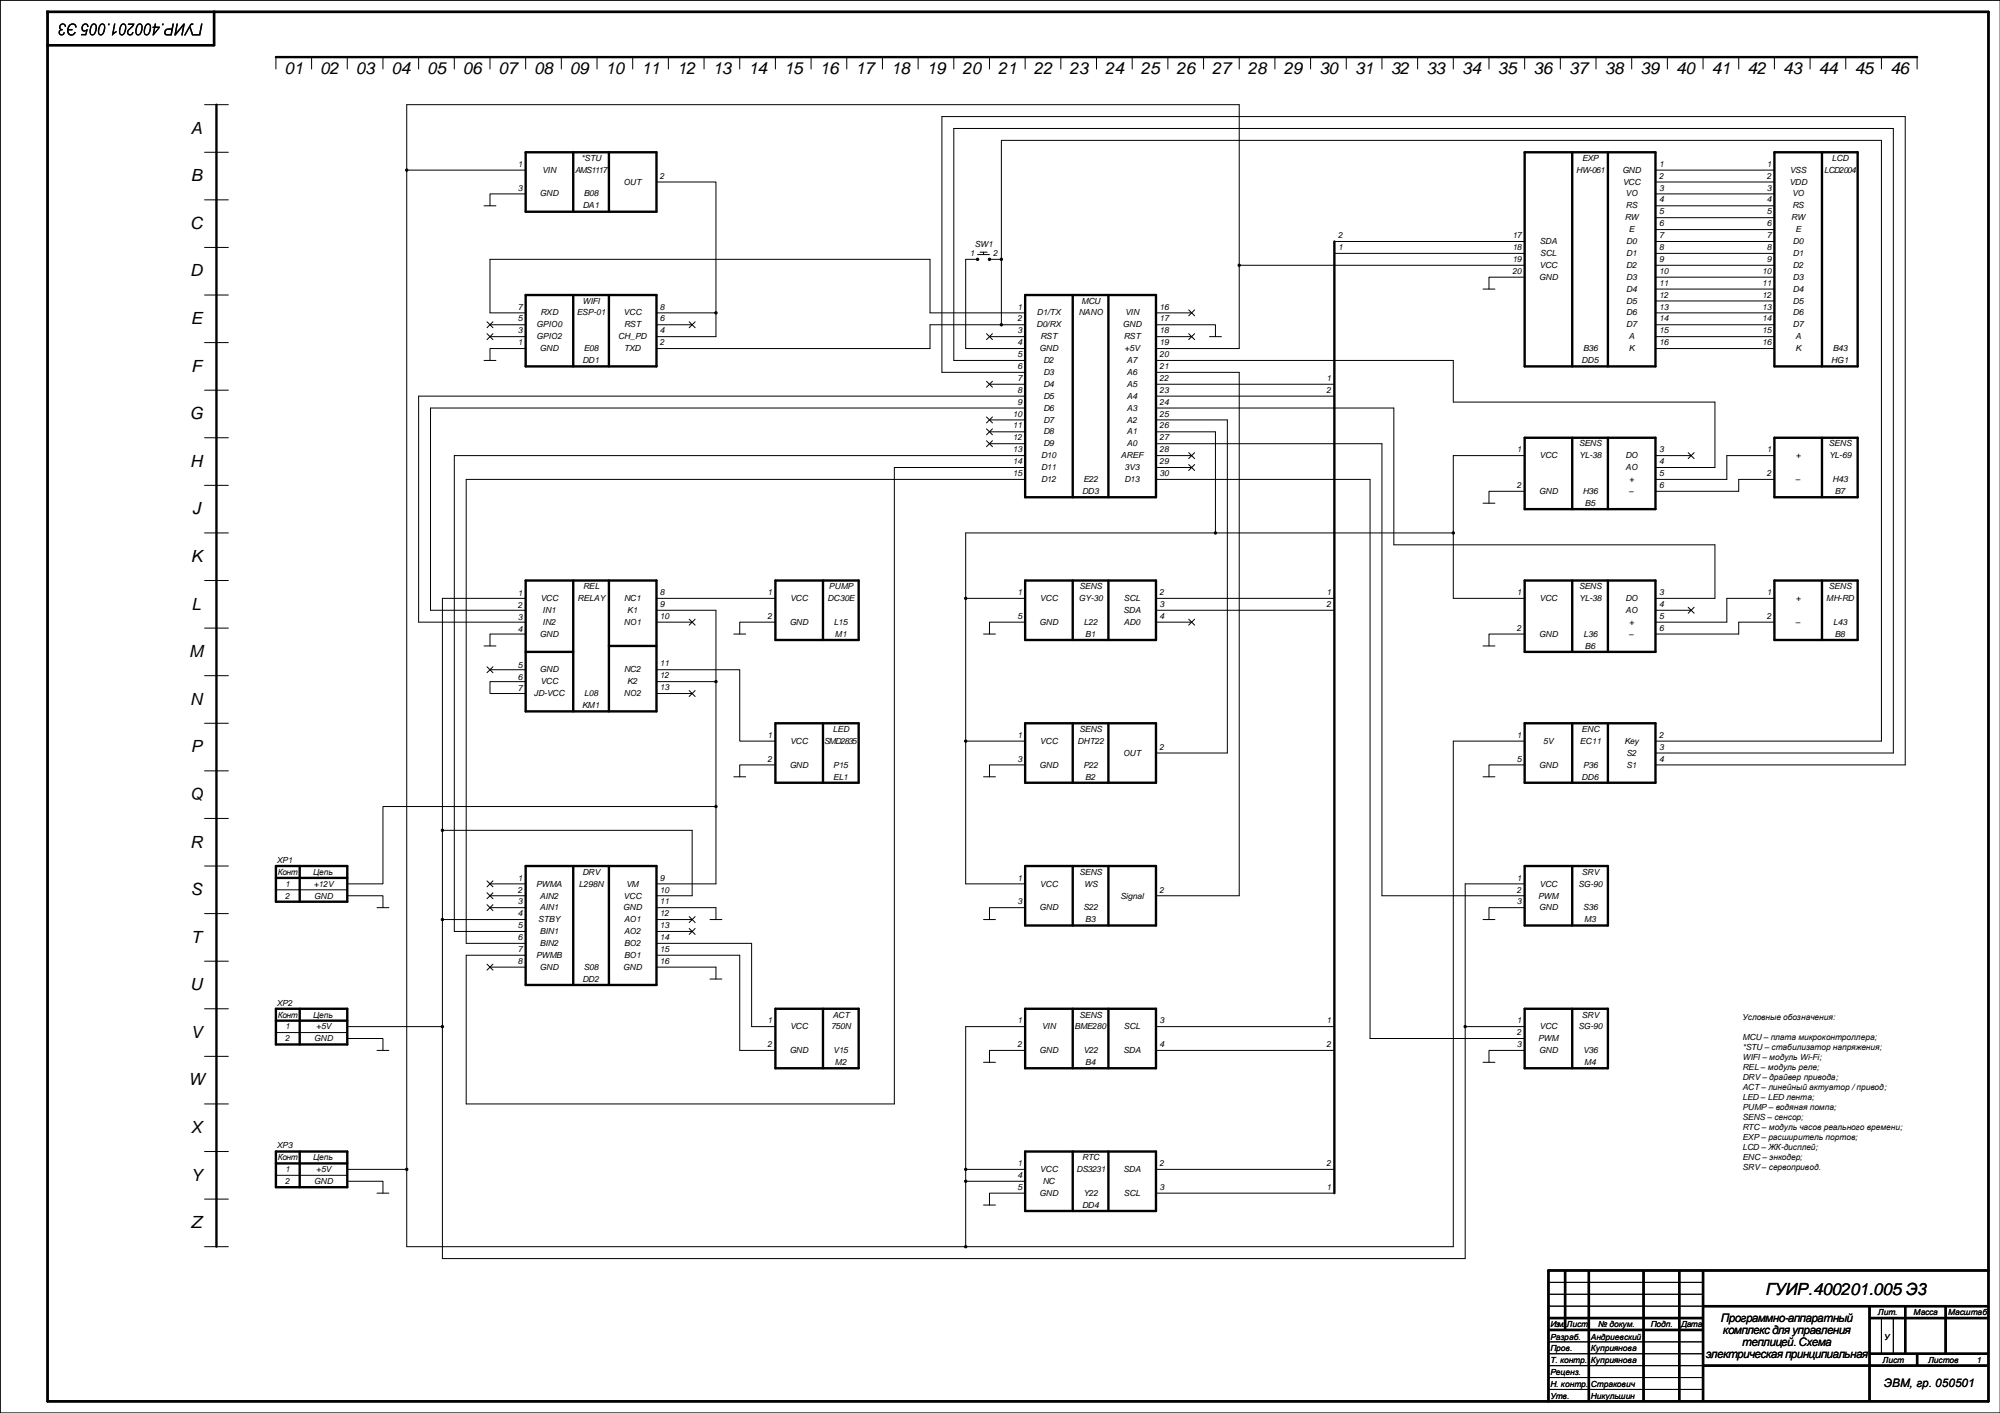
[picture p137: page 1]

23
24

1 | +12V
2 | GND

1 | +5 V

ГУИР.400201.005 Э3

Программно Программно -аппаратный -аппаратный комплекс для управления комплекс для управления теплицей. Схема теплицей. Схема электрическая принципиальная электрическая принципиальная | Лит. | Масса | Масштаб

Изм. Лист | | № докум. | Подп. | Дата
Разраб. | | Андриевский
Пров. | | Куприянова
Т. контр. | Куприянова | | | | | 1 1
Реценз. | | | | | ЭВМ, гр. 050501
Н. контр. | Стракович
Утв. | Никульшин
