LvYegor/diploma-bsuir/doc/pdf/Схема программы_А1 (А2х2).pdf

A

B

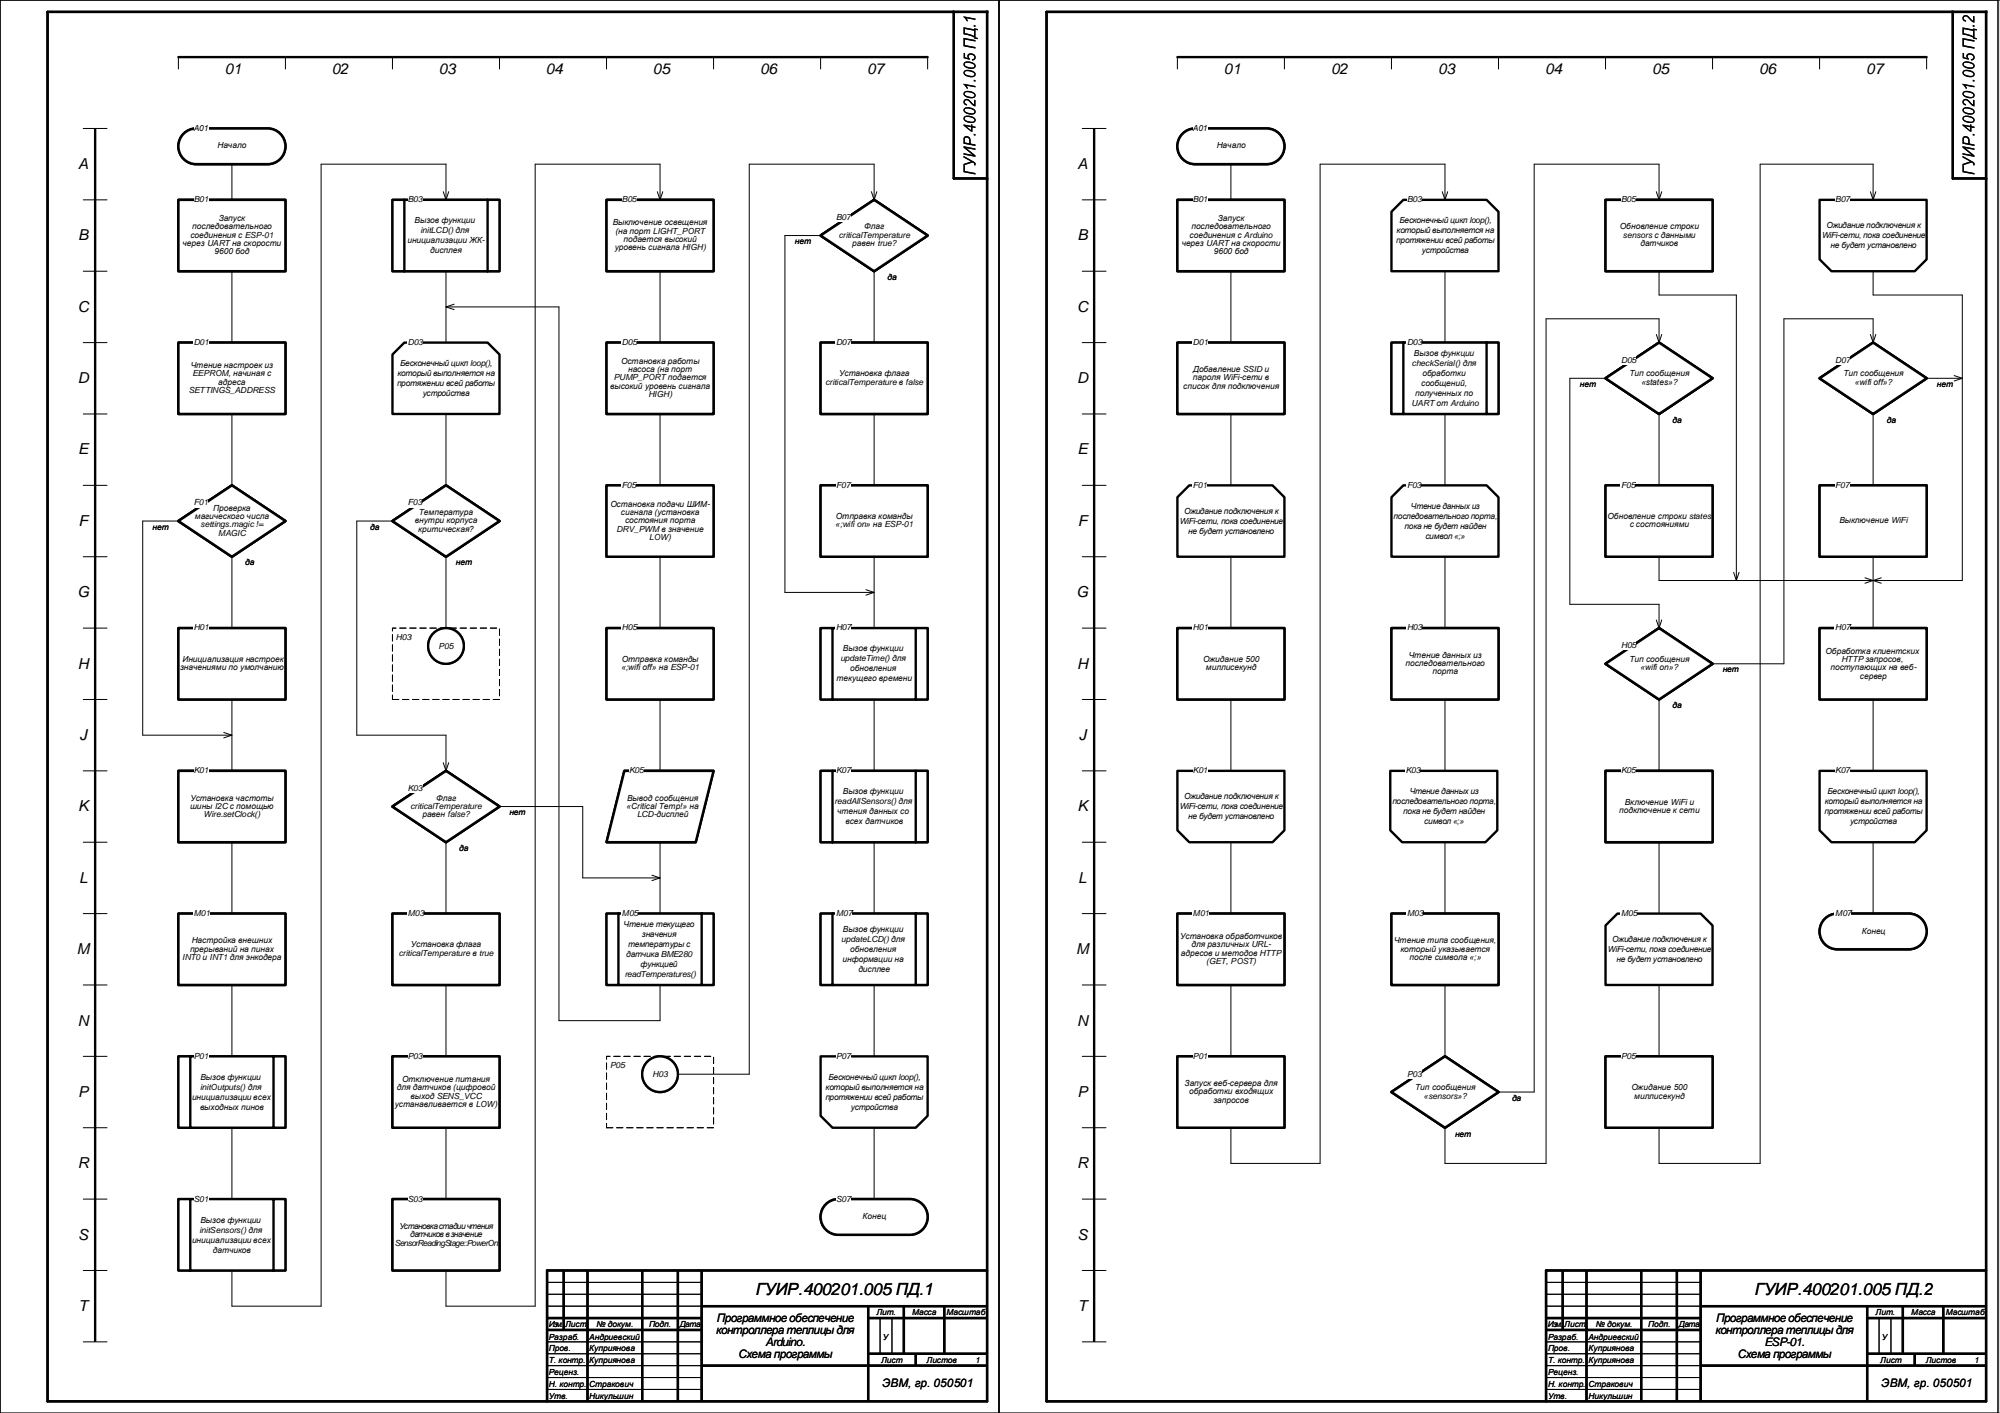
[picture p138: page 1]

последовательного
соединения с ESP-01
через UART на скорости

соединения с Arduino

Ожидание подключения к
WiFi-сети, пока соединение
не будет установлено

Чтение данных из
последовательного порта,
пока не будет найден
символ «;»

Отправка команды
«;wifi on» на ESP-01

«;wifi off» на ESP-01

Запуск веб-сервера для
обработки входящих
