LvYegor/diploma-bsuir/doc/pdf/Вводный плакат.pdf

# Программно-аппаратный комплекс для управления теплицей на основе беспроводной технологии

## Цель:

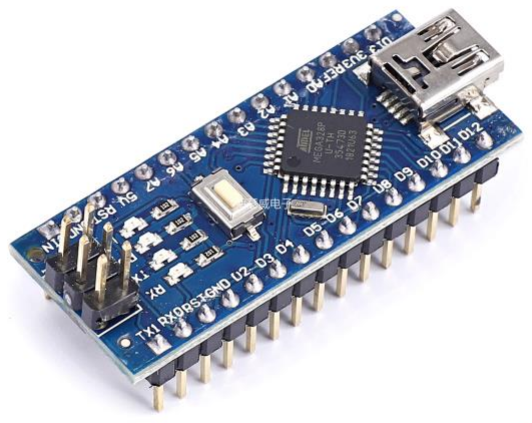
[picture p139: figure]
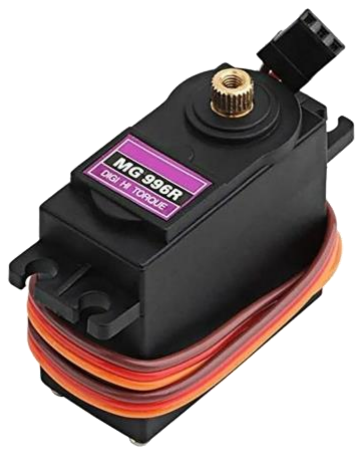
[picture p140: figure]

Разработать | программно-аппаратный | комплекс | для
управления | теплицей | на | основе | беспроводной
технологии

## Задачи:

•проектирование контроллера теплицы, представленного в виде платы микроконтроллера и набора датчиков для сбора данных;
•разработка программного обеспечения для обработки информации и обеспечения взаимодействия между компонентами;
•реализация удаленного мониторинга и управления теплицей через API;
- тестирование функционала беспроводного управления и совместимости с подключенными устройствами.

## Используемые модули

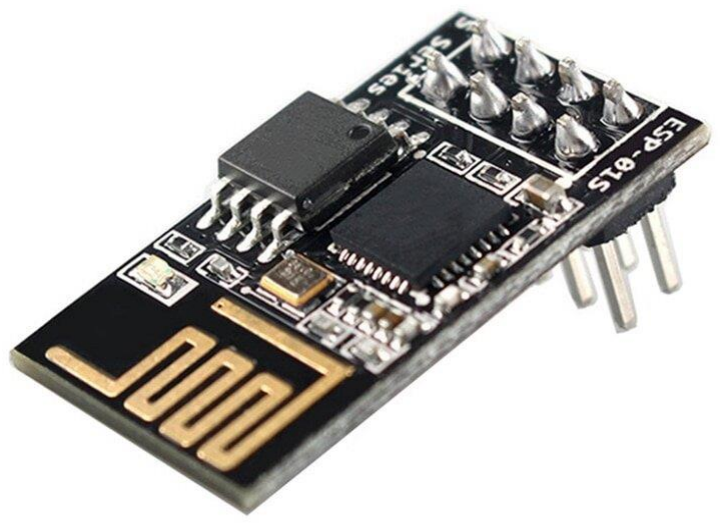
[picture p141: figure]

## Используемые технологии

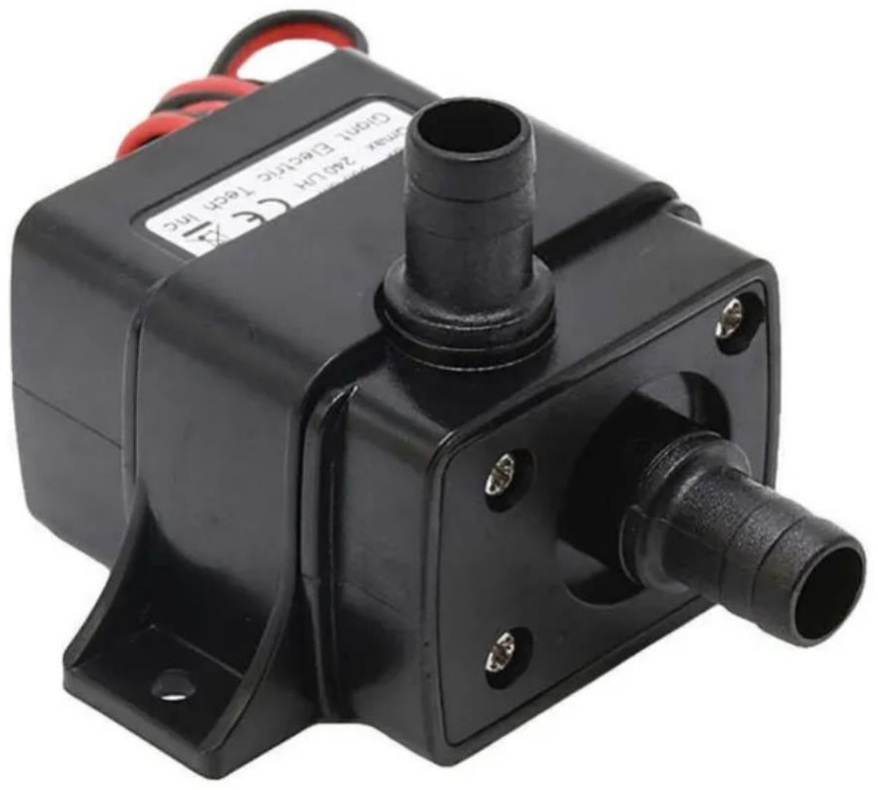
[picture p142: figure]
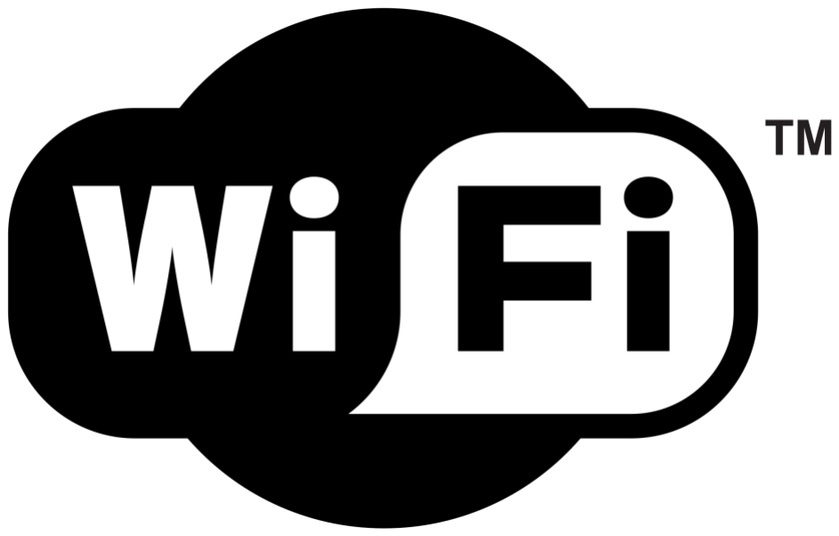
[picture p143: figure]
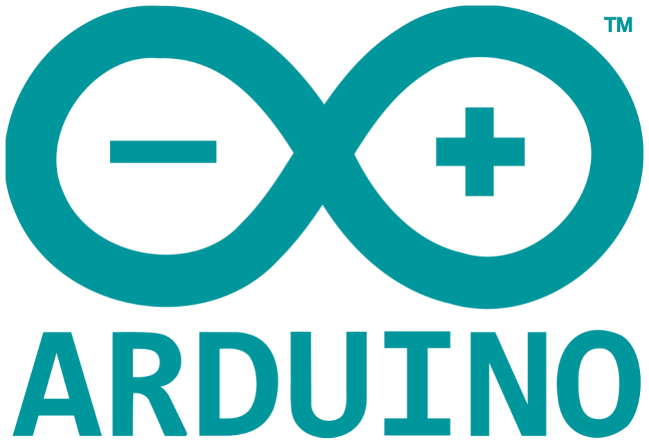
[picture p144: figure]
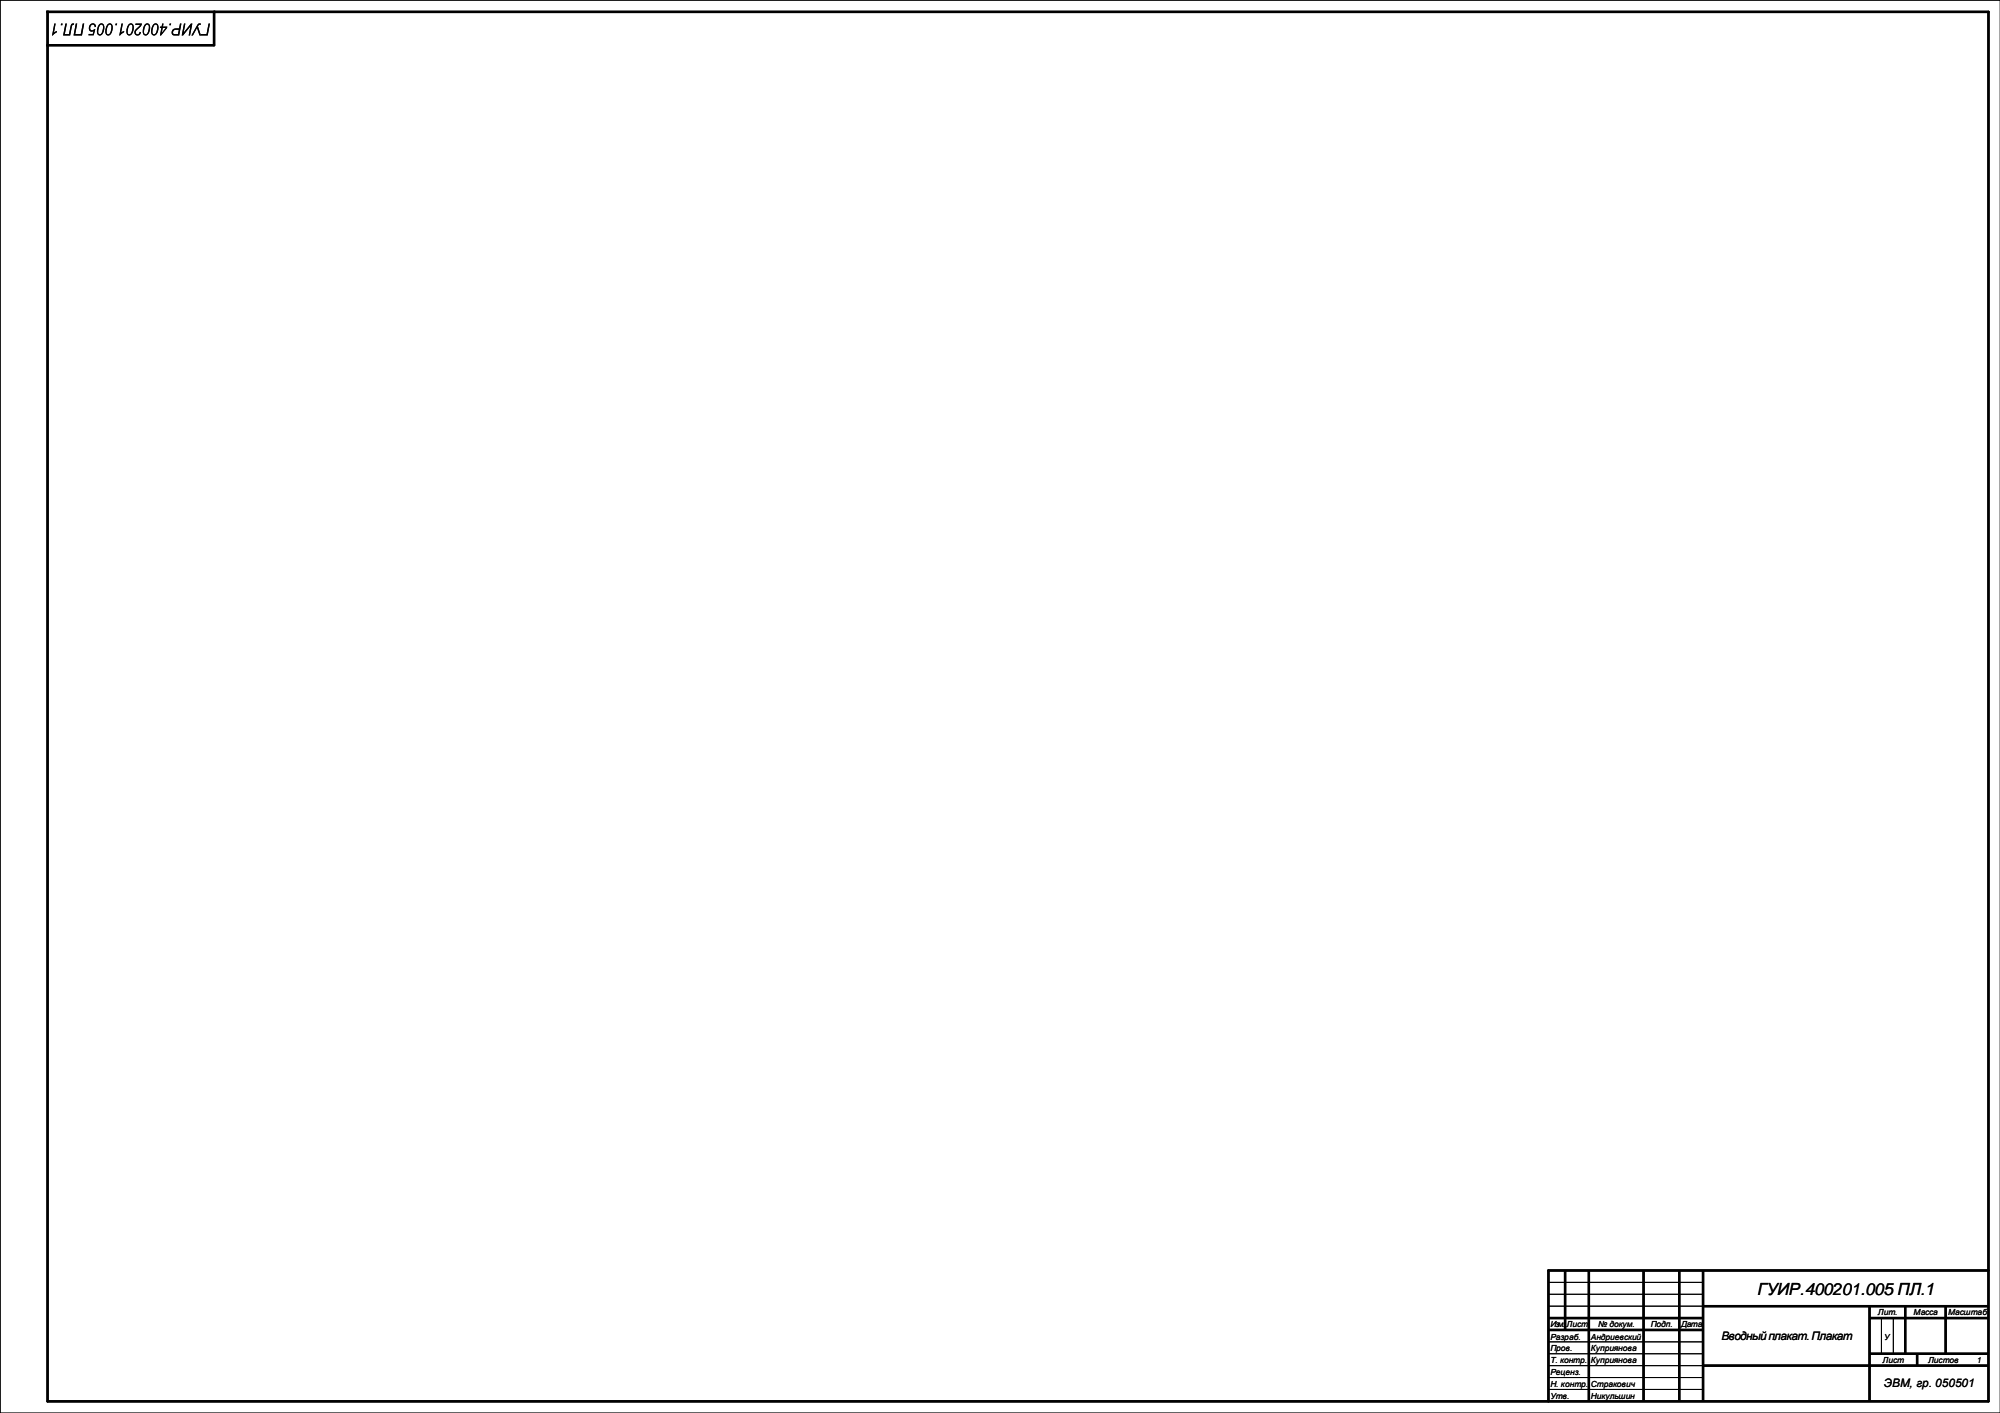
[picture p145: page 2]

ГУИР.400201.005 ПЛ.1

Вводный плакат. Плакат | Лит. | Масса | Масштаб

Изм. Лист | | № докум. | Подп. | Дата | | | У У
Разраб. | | Андриевский
Пров. | | Куприянова
Т. контр. | Куприянова | | | | Лист | Листов Листов 1 1
Реценз. | | | | | ЭВМ, гр. 050501
Н. контр. | Стракович
Утв. | Никульшин
