LvYegor/diploma-bsuir/doc/pdf/Заключительный плакат.pdf

# Программно-аппаратный комплекс для управления теплицей на основе беспроводной технологии

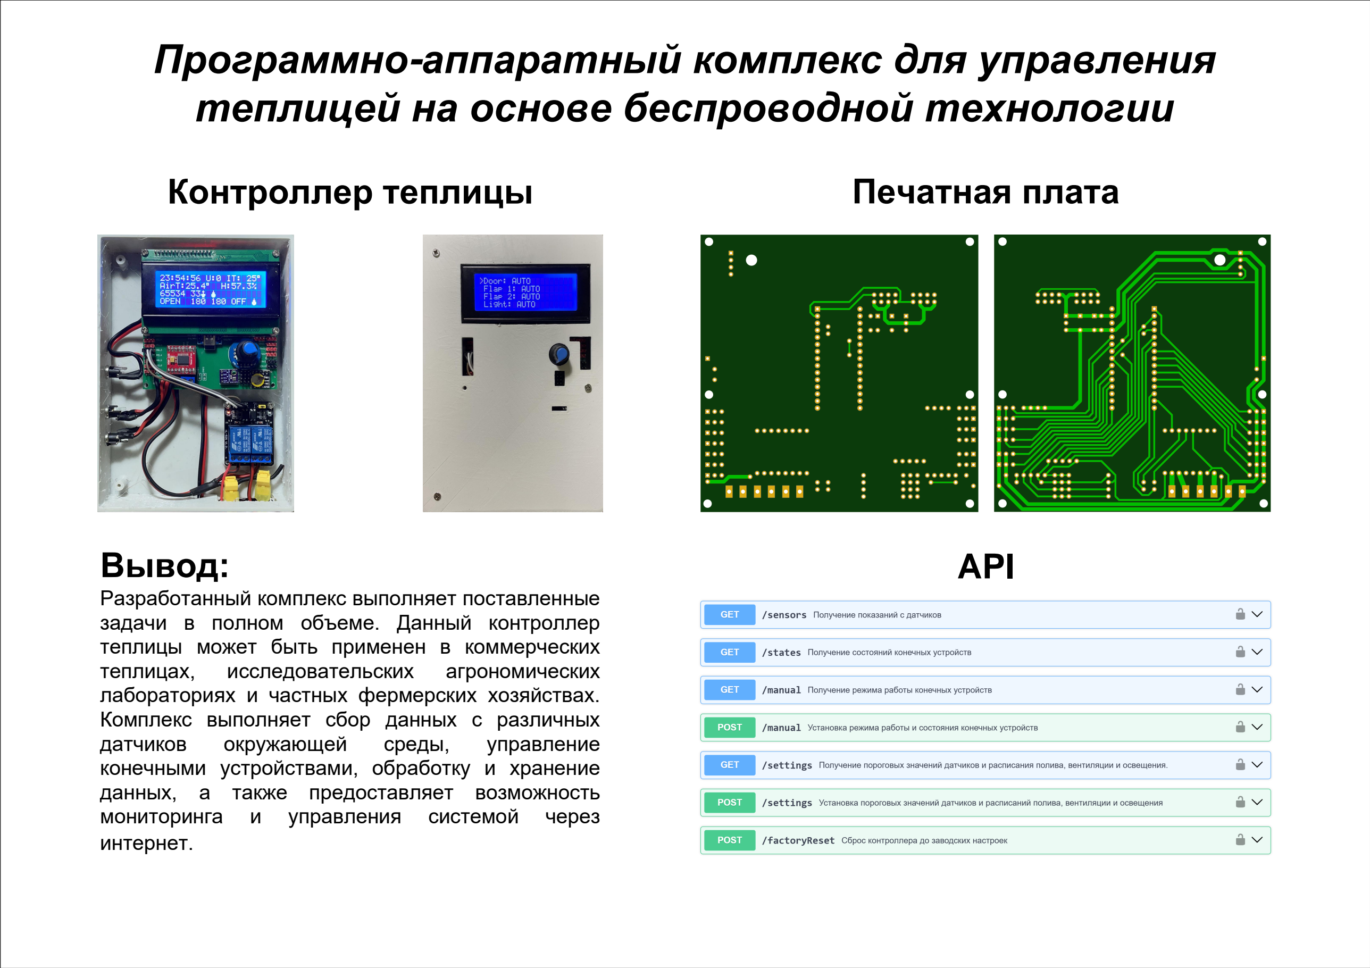
[picture p146: page 1]

## Вывод:

Разработанный комплекс выполняет поставленные задачи в полном объеме. Данный контроллер теплицы может быть применен в коммерческих
теплицах, | исследовательских | агрономических
лабораториях и частных фермерских хозяйствах. Комплекс выполняет сбор данных с различных
датчиков | окружающей | среды, | управление
конечными устройствами, обработку и хранение данных, а также предоставляет возможность
мониторинга | и | управления | системой | через
интернет.
Контроллер теплицы | Печатная плата

## API

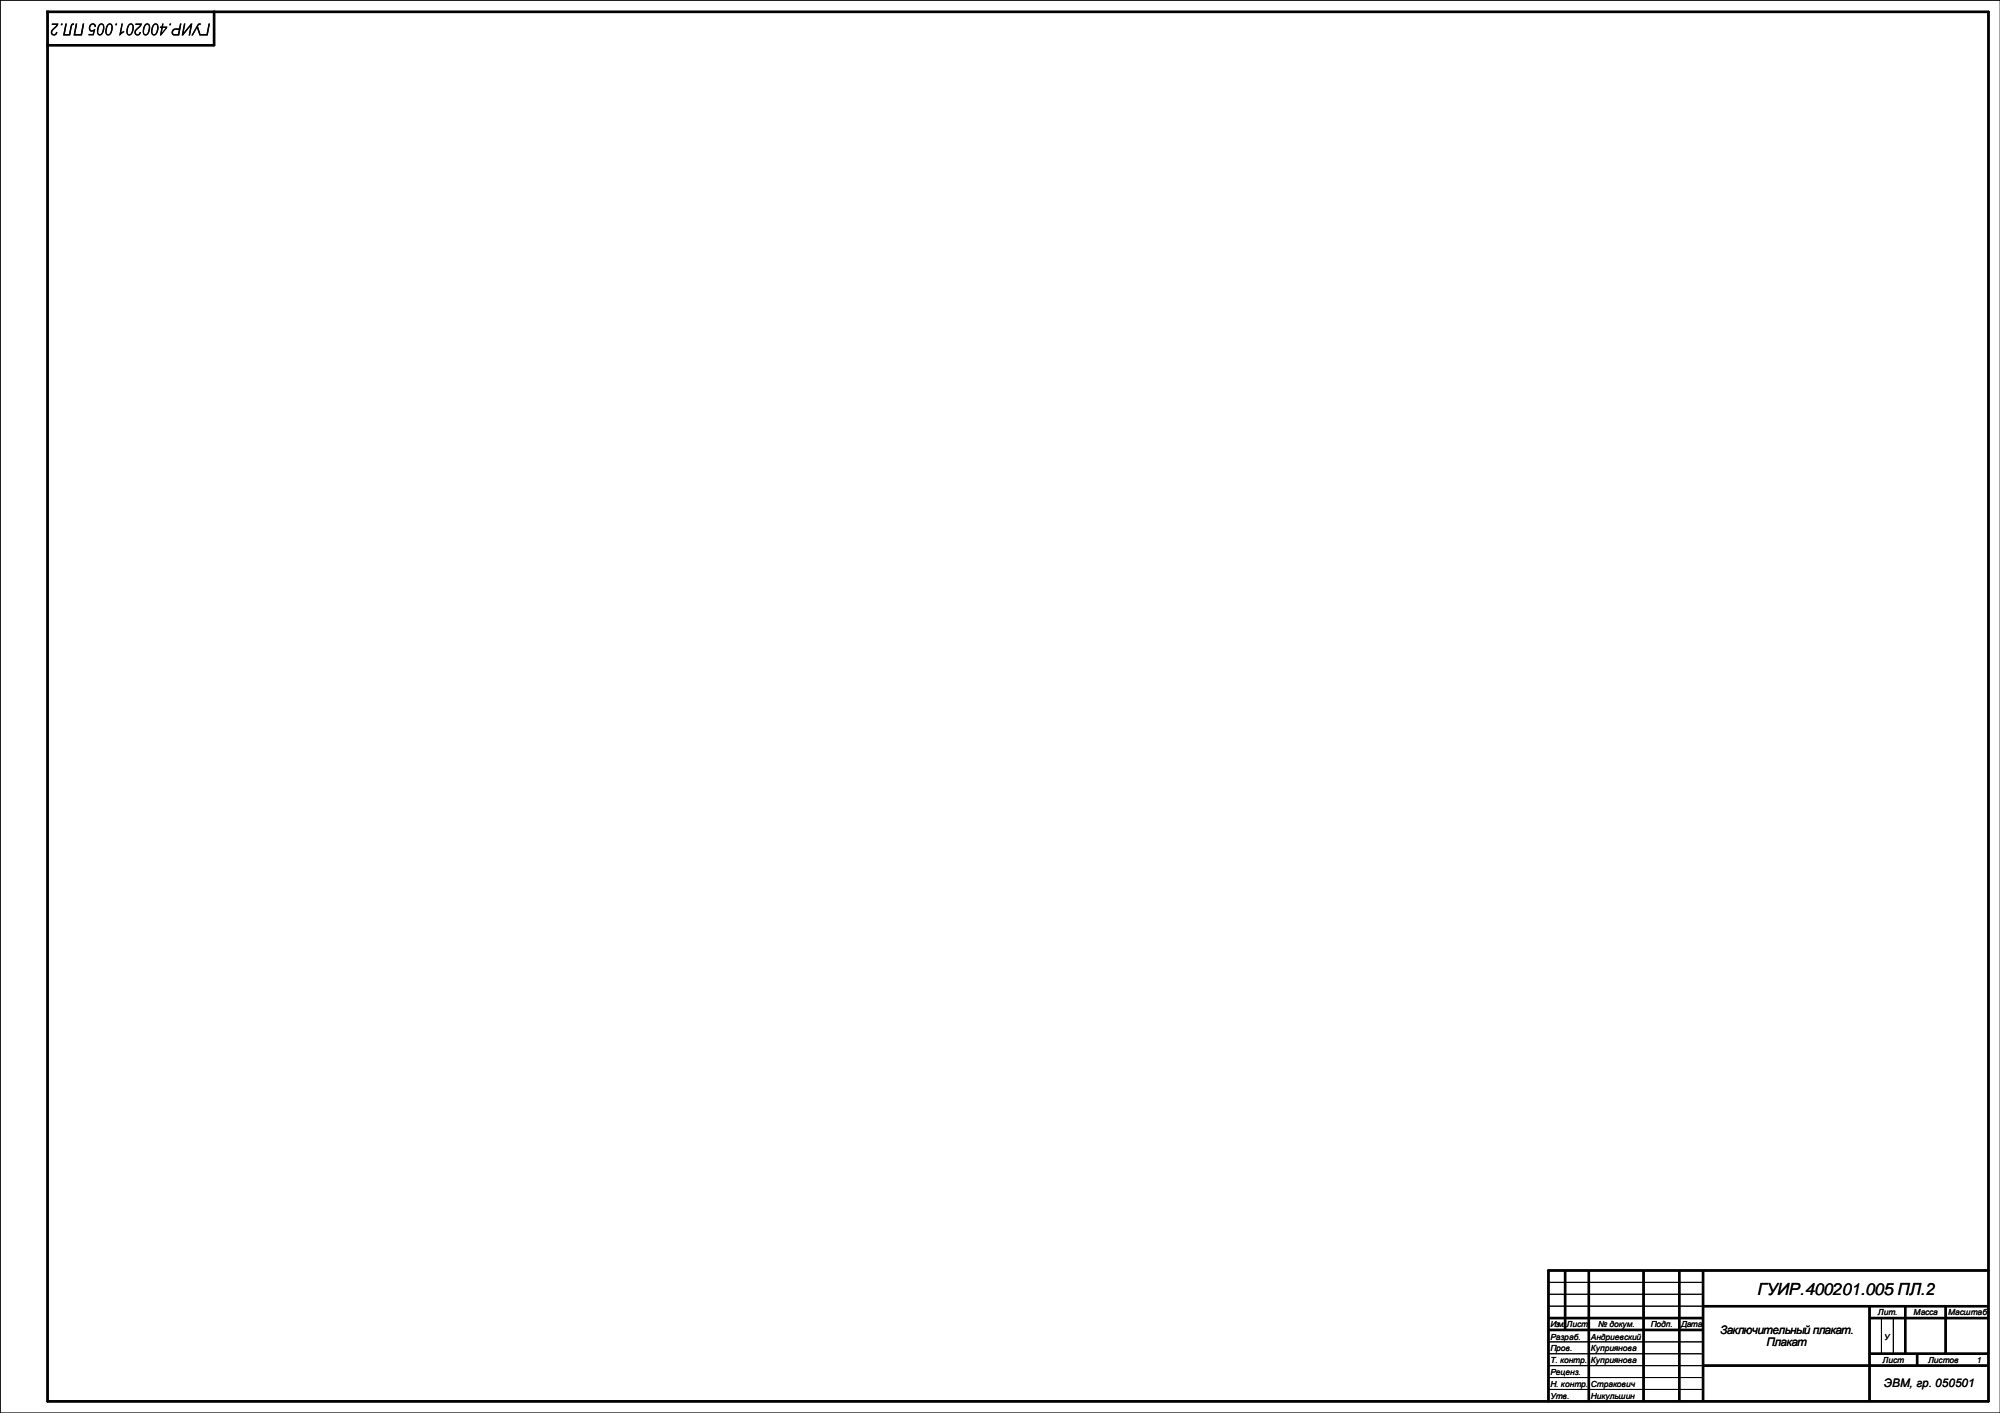
[picture p147: page 2]

ГУИР.400201.005 ПЛ.2

Заключительный плакат. Заключительный плакат. Плакат Плакат | Лит. | Масса | Масштаб

Изм. Лист | | № докум. | Подп. | Дата | | | У У
Разраб. | | Андриевский
Пров. | | Куприянова
Т. контр. | Куприянова | | | | Лист | Листов Листов 1 1
Реценз. | | | | | ЭВМ, гр. 050501
Н. контр. | Стракович
Утв. | Никульшин
