LvYegor/diploma-bsuir/doc/pdf/Структурная_А1.pdf

# Блок обновления выходов по данным

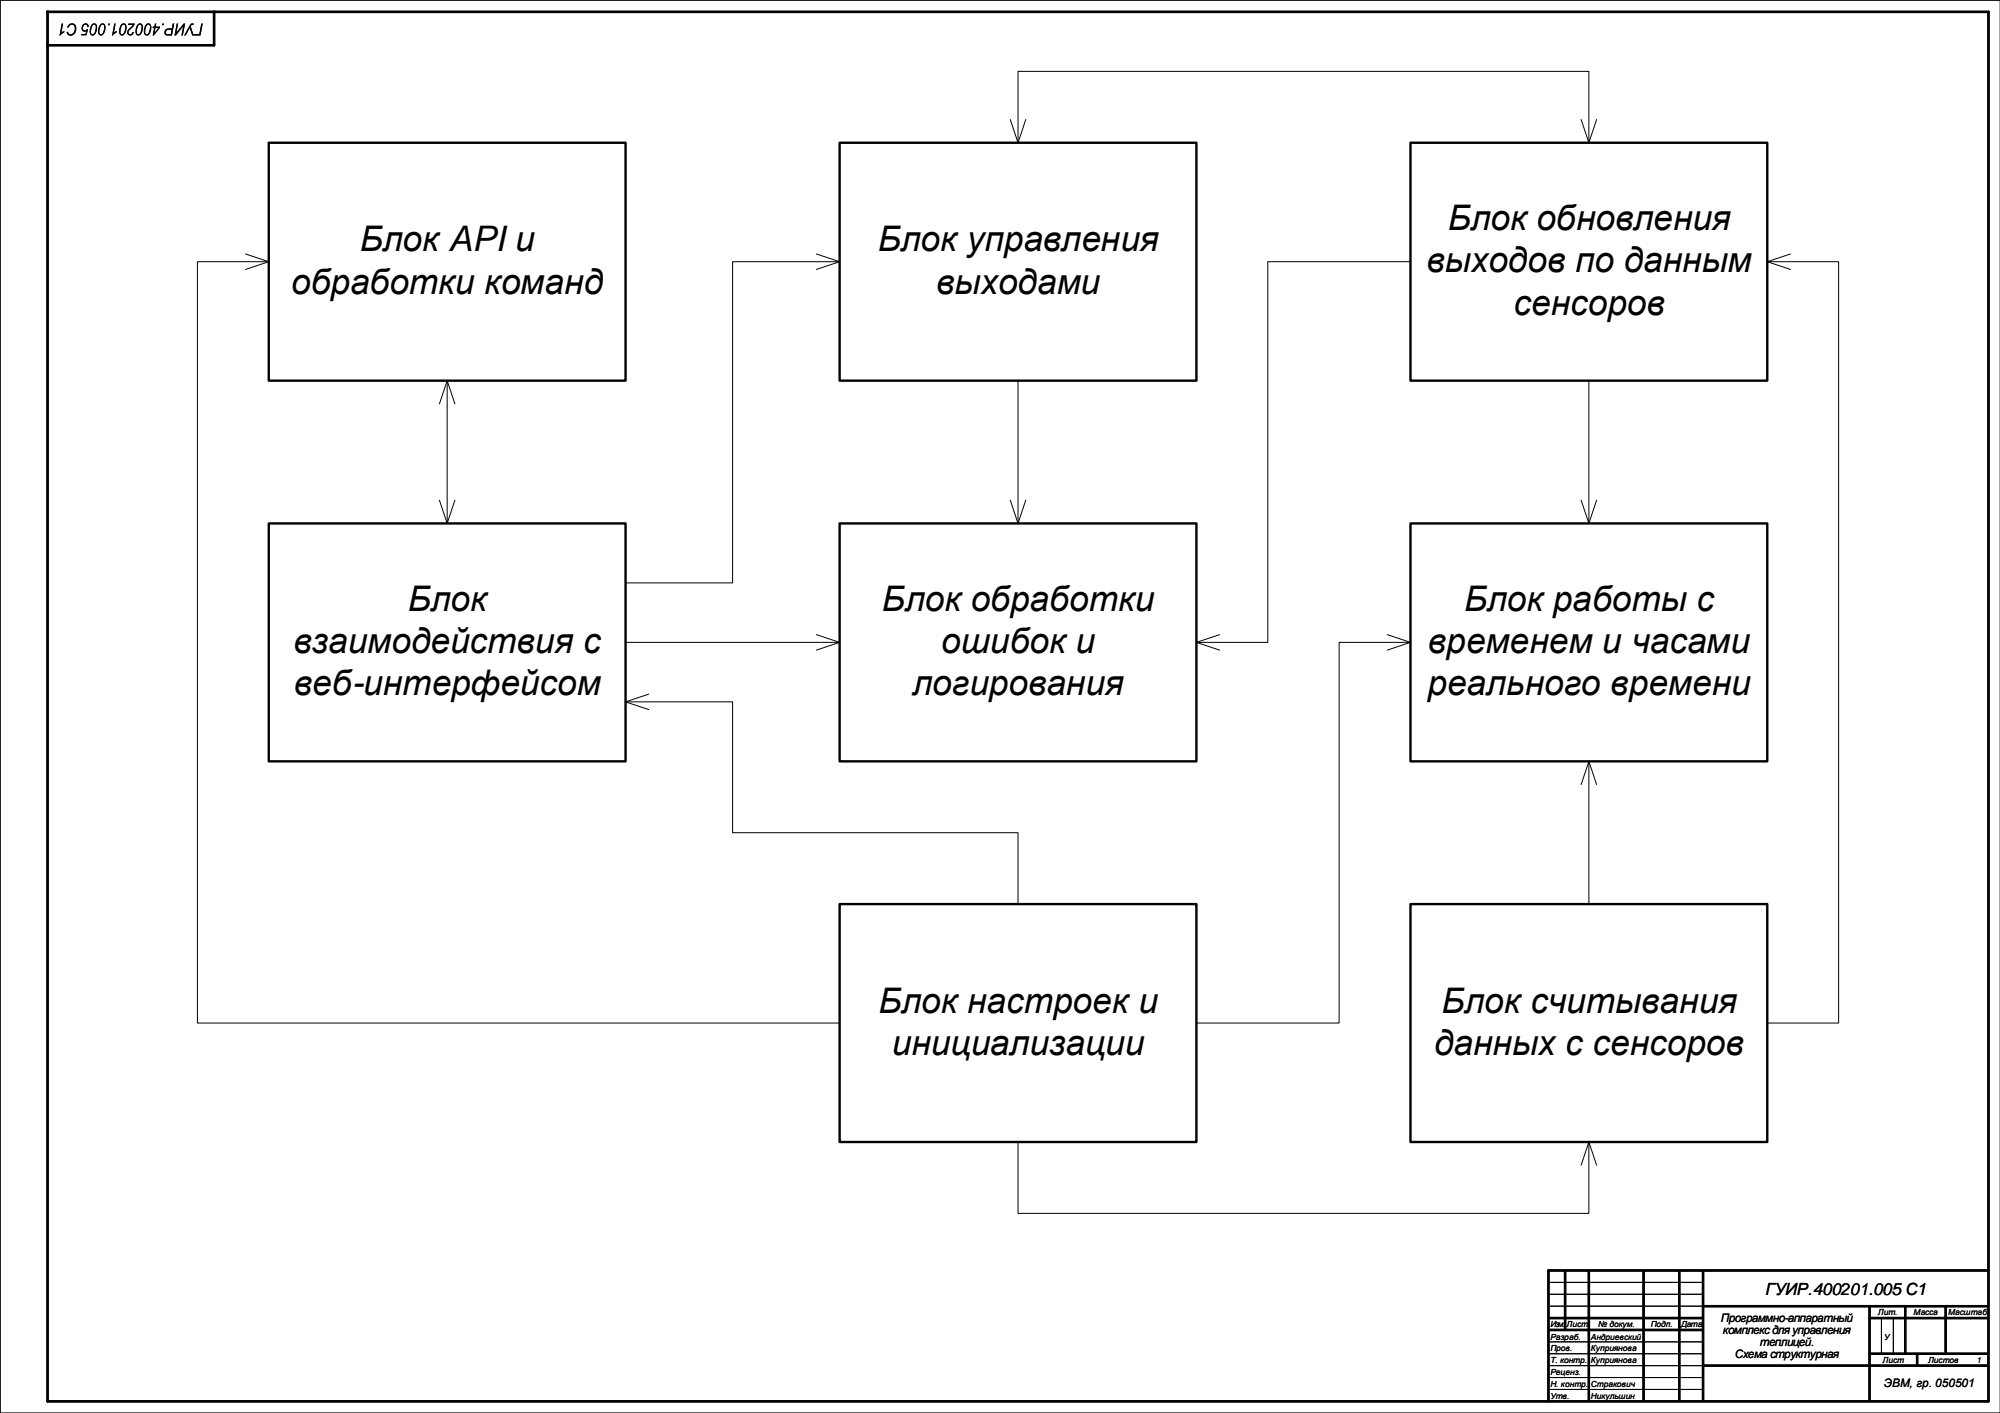
[picture p148: page 1]
сенсоров; Блок управления выходами; Блок взаимодействия с веб-интерфейсом; Блок обработки ошибок и логирования; Блок работы с временем и часами реального времени; Блок настроек и инициализации; Блок считывания данных с сенсоров; Блок API и обработки команд

ГУИР.400201.005 С1

Программно-аппаратный Программно-аппаратный комплекс для управления комплекс для управления теплицей. теплицей. Схема структурная Схема структурная | Лит. | Масса | Масштаб

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
