LvYegor/diploma-bsuir/doc/pdf/Чертеж_электромонтажный_А4.pdf

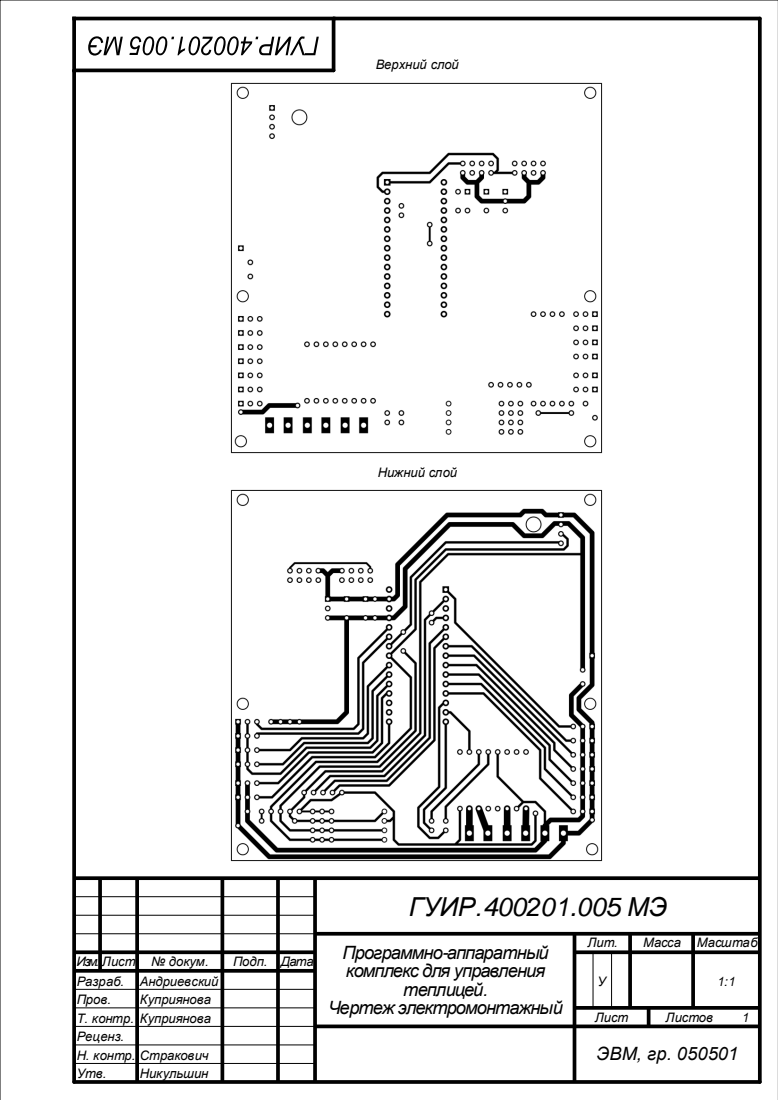
[picture p149: page 1]
Верхний слой; Нижний слой

ГУИР.400201.005 МЭ

Программно-аппаратный комплекс для управления теплицей. Чертеж электромонтажный | Лит. | Масса | Масштаб

Изм. Лист | | № докум. | Подп. | Дата | | | У | | 1:1
Разраб. | | Андриевский
Пров. | | Куприянова
Т. контр. | Куприянова | | | | Лист | Листов 1
Реценз. | | | | | ЭВМ, гр. 050501
Н. контр. | Стракович
Утв. | Никульшин
