LvYegor/diploma-bsuir/doc/pdf/Эл.Структурная_А1.pdf

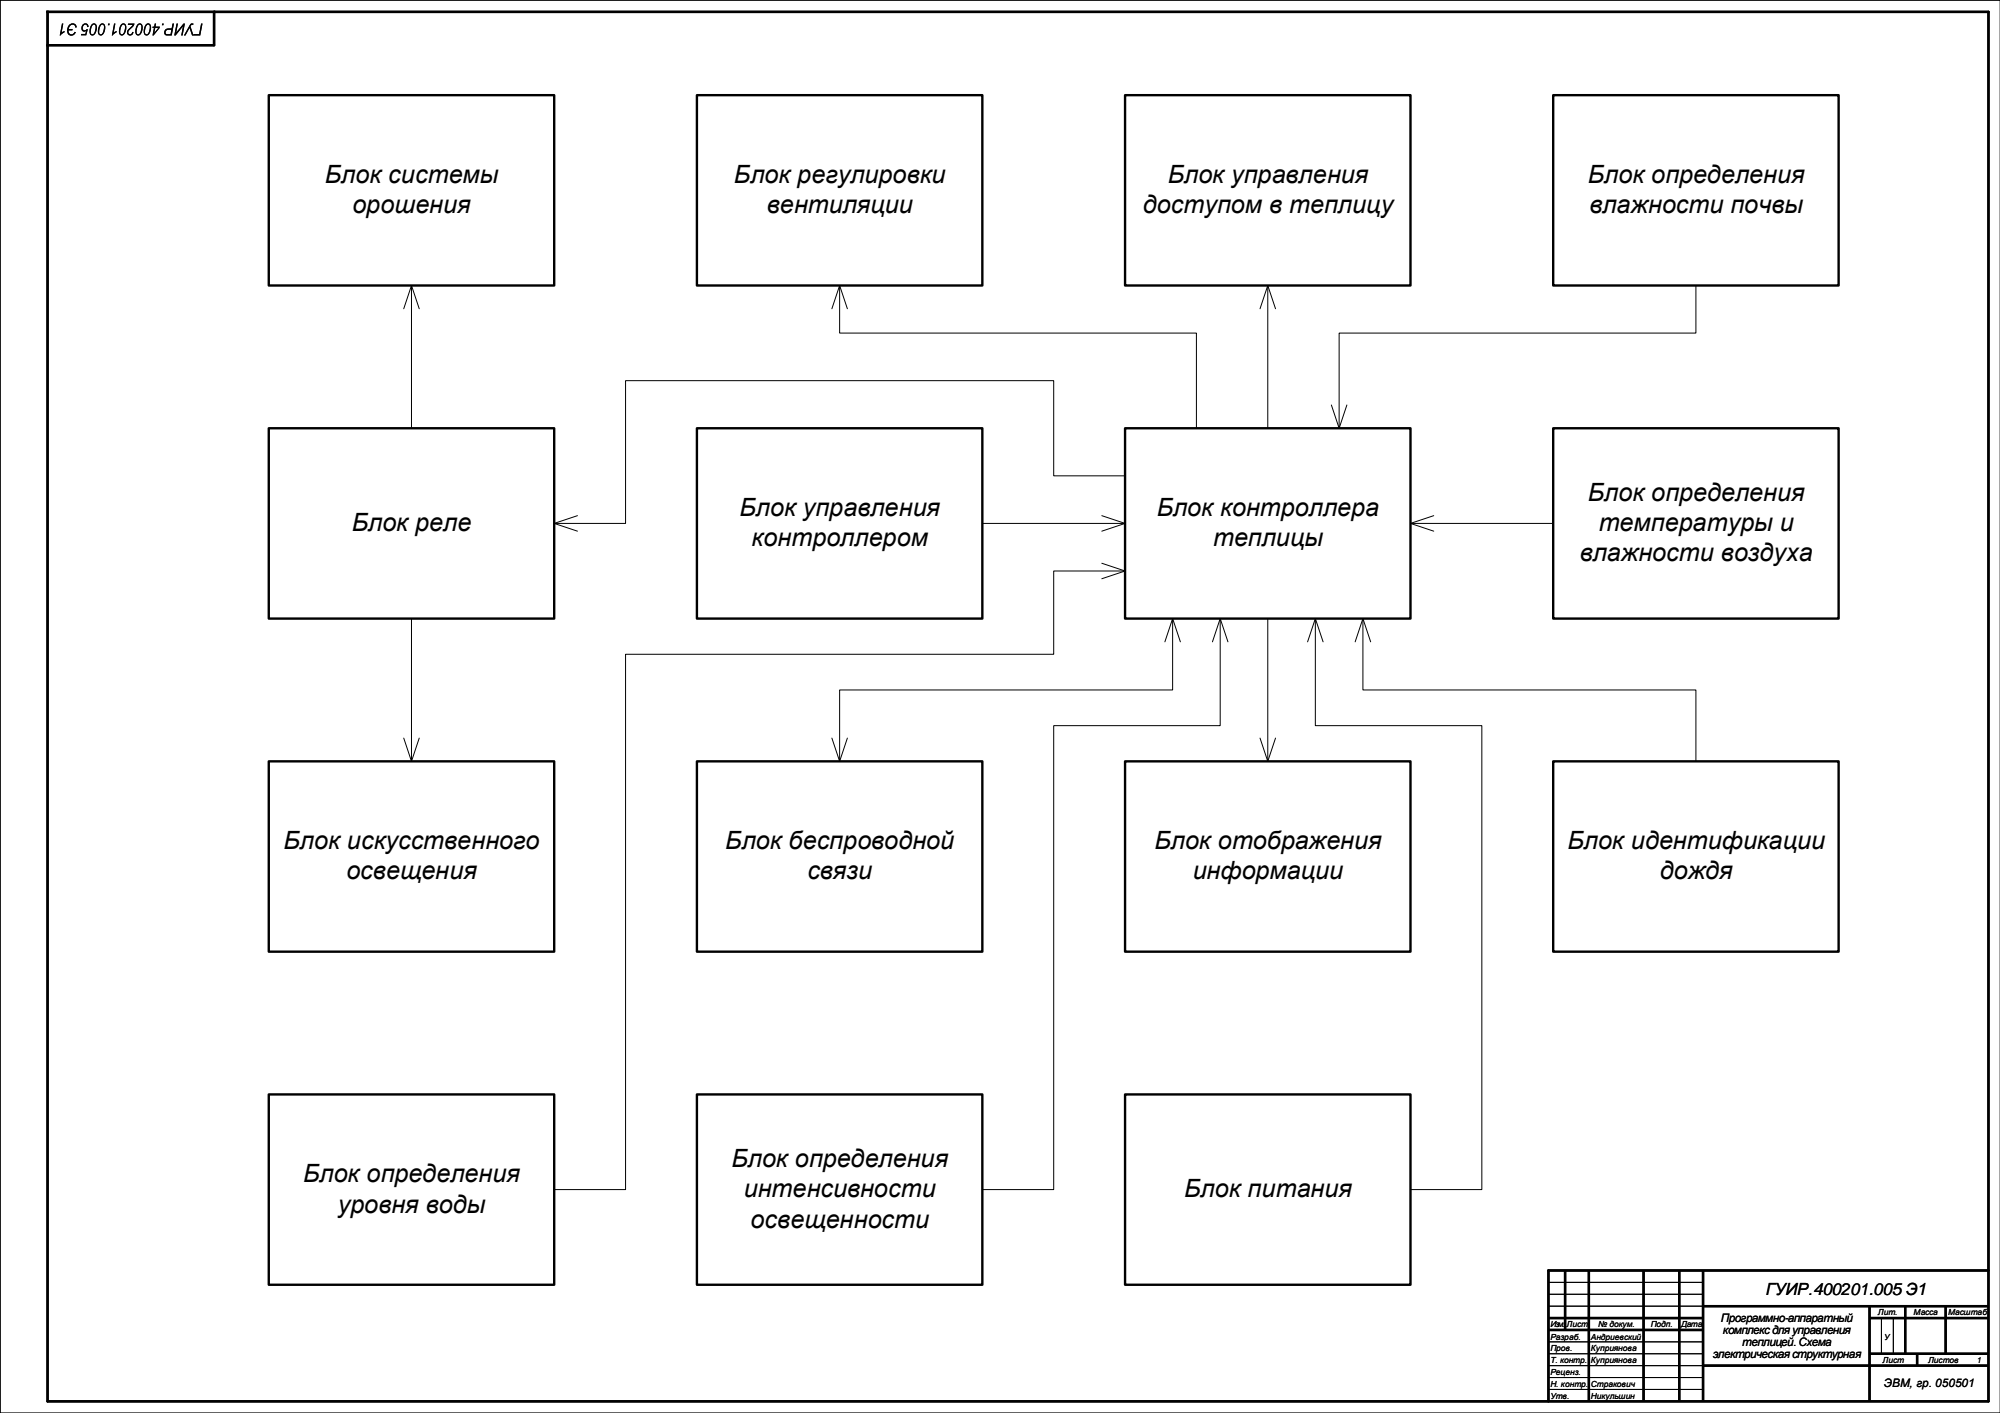
[picture p150: page 1]
Блок регулировки вентиляции; Блок реле; Блок контроллера теплицы; Блок управления контроллером; Блок определения температуры и влажности воздуха; Блок управления доступом в теплицу; Блок системы орошения; Блок питания; Блок отображения информации; Блок беспроводной связи; Блок искусственного освещения; Блок определения влажности почвы; Блок идентификации дождя; Блок определения уровня воды; Блок определения интенсивности освещенности

ГУИР.400201.005 Э1

Программно-аппаратный Программно-аппаратный комплекс для управления комплекс для управления теплицей. Схема теплицей. Схема электрическая структурная электрическая структурная | Лит. | Масса | Масштаб

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
