LvYegor/diploma-bsuir/doc/img_control/IMG_0616.jpg

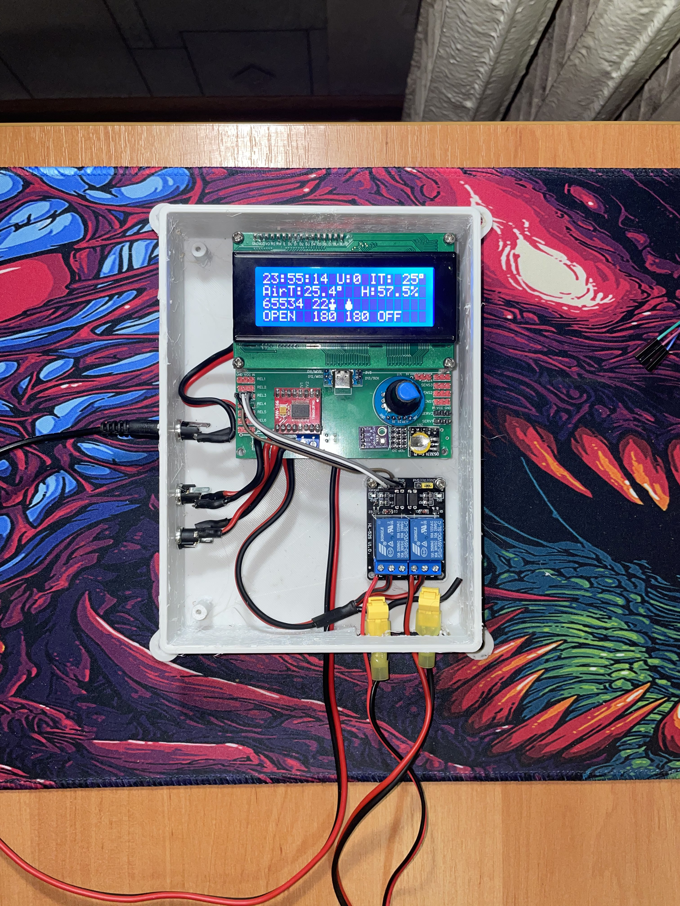
doc/img_control/IMG_0616.jpg
