LvYegor/diploma-bsuir/doc/img_control/IMG_0618.jpg

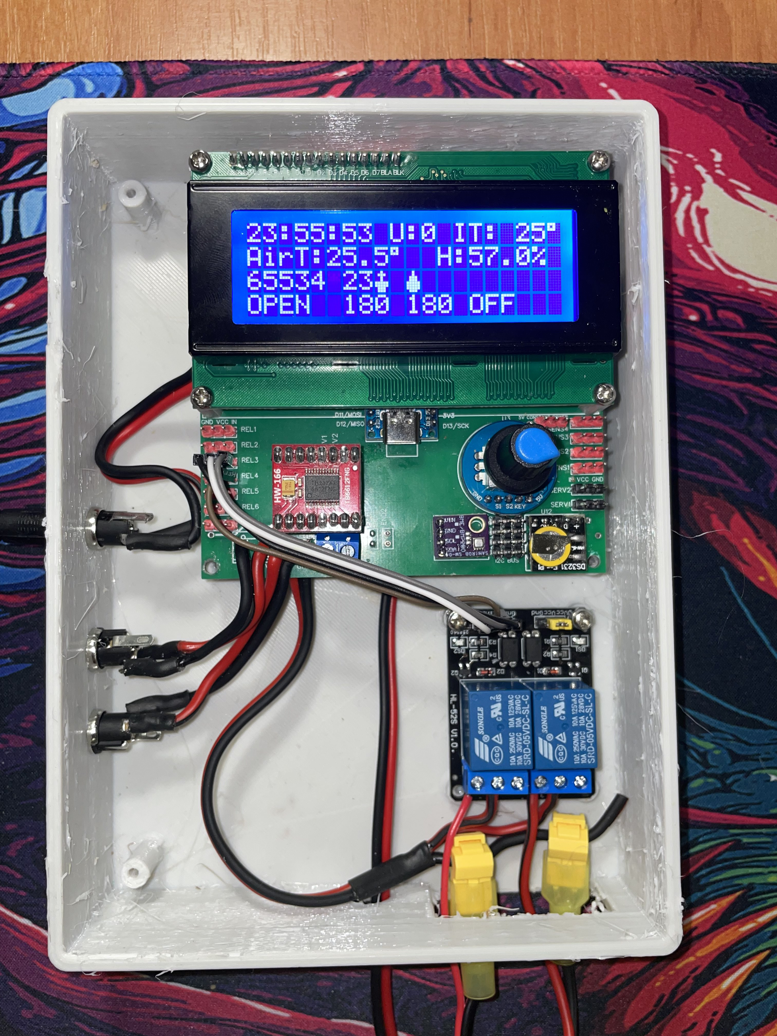
doc/img_control/IMG_0618.jpg
