LvYegor/diploma-bsuir/doc/img_control/IMG_0619.jpg

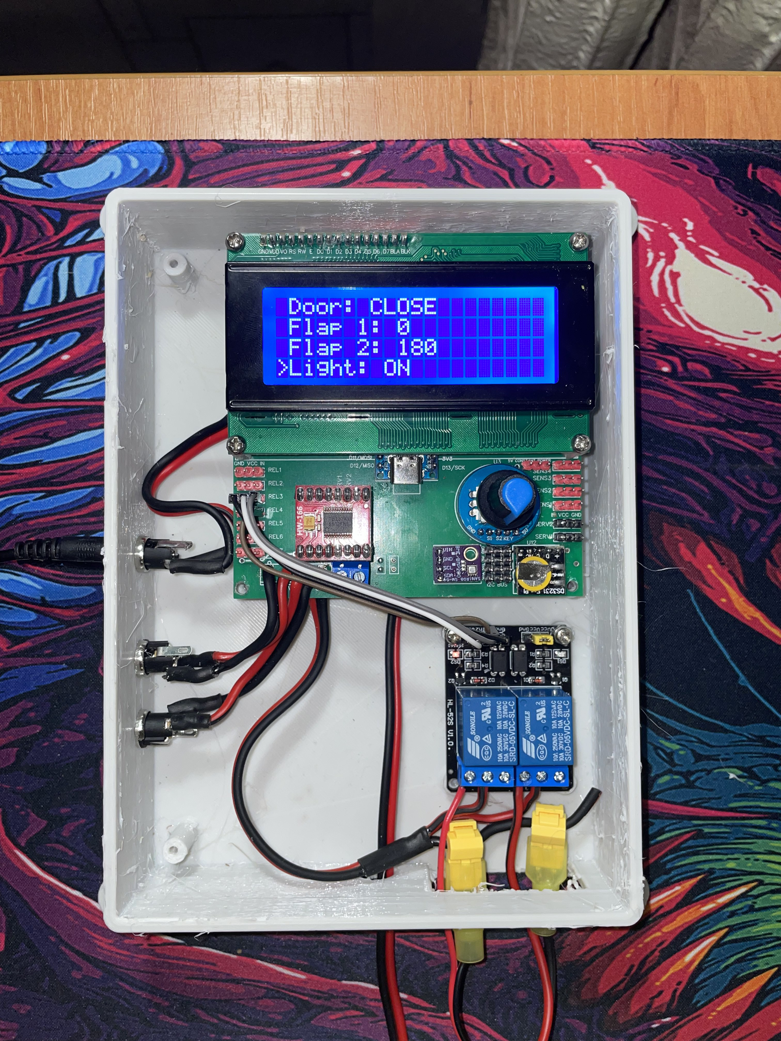
doc/img_control/IMG_0619.jpg
