LvYegor/diploma-bsuir/doc/img_control/IMG_0621.jpg

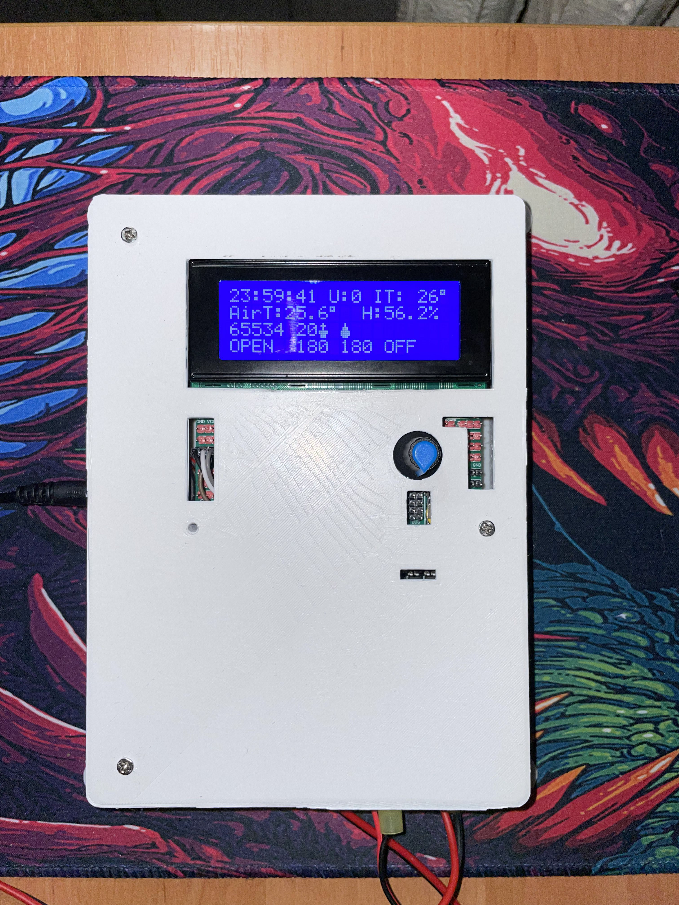
doc/img_control/IMG_0621.jpg
