LvYegor/diploma-bsuir/doc/img_control/IMG_0622.jpg

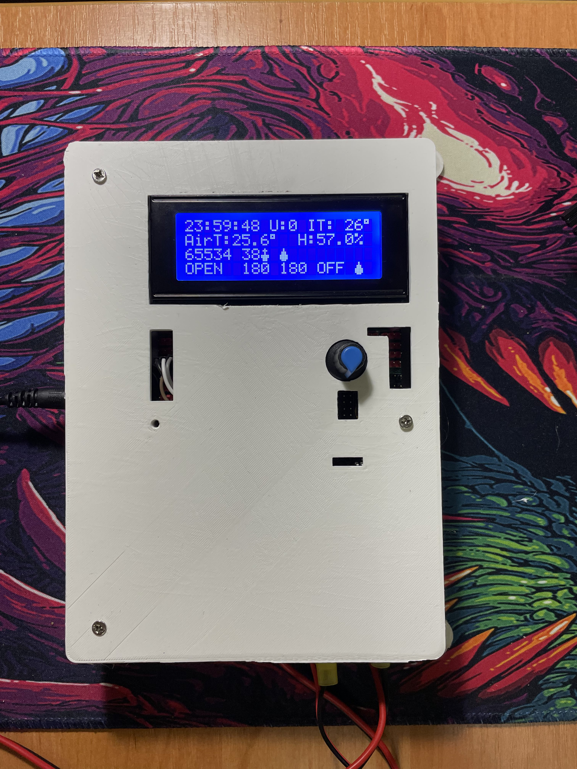
doc/img_control/IMG_0622.jpg
