LvYegor/diploma-bsuir/doc/img_control/IMG_0624.jpg

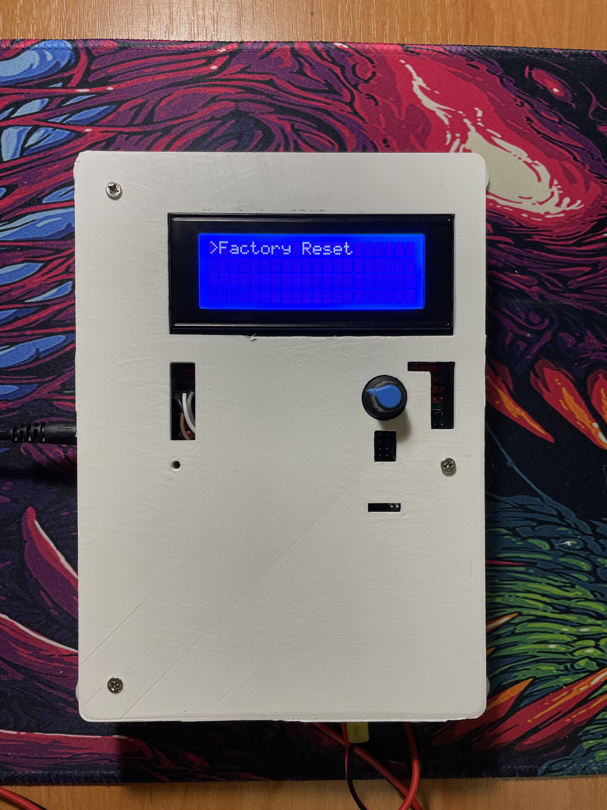
doc/img_control/IMG_0624.jpg
