LvYegor/diploma-bsuir/doc/img_control/IMG_0602.jpg

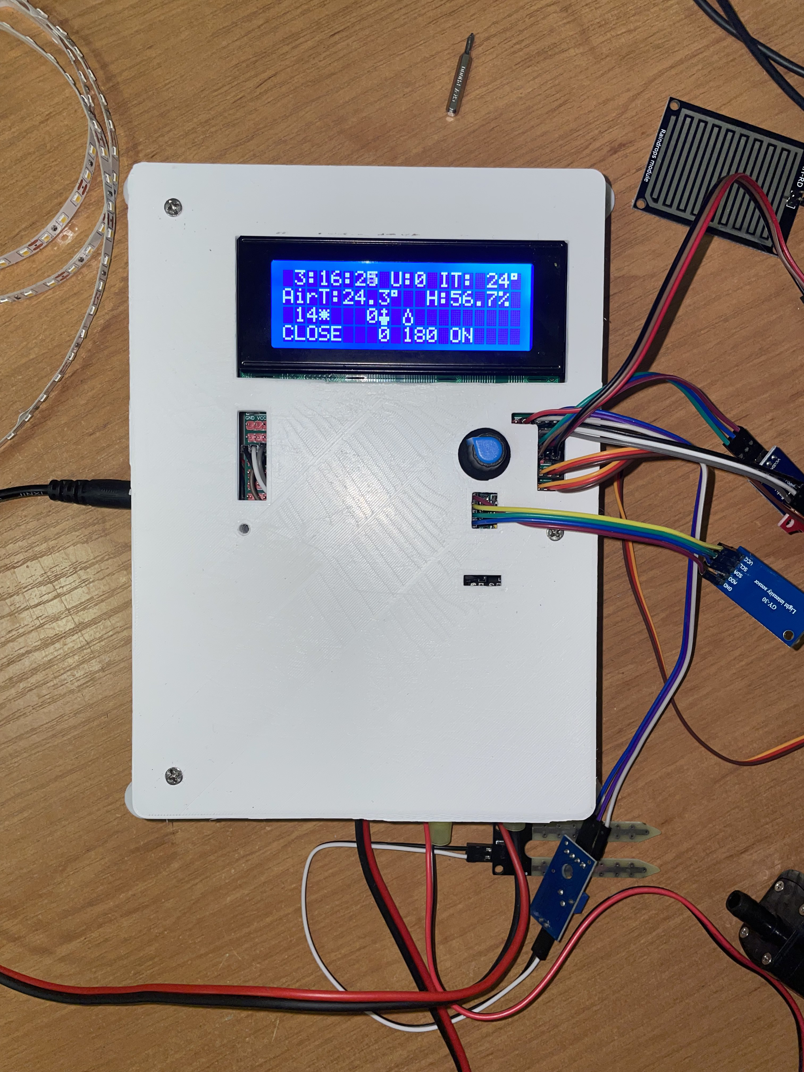
doc/img_control/IMG_0602.jpg
